ETML-ES-SLO/PRJ_2224_BuzzerWireGame/hard/A/2224_BuzzerWireGame/Project Outputs for 2224_BuzzerWireGame/EuroCircuits/2224_BuzzerWireGame-RectHoles.TXT

M48
;Layer_Color=9474304
;FILE_FORMAT=4:3
METRIC,LZ
;TYPE=PLATED
T10F00S00C2.200
;TYPE=NON_PLATED
%
G90
G05
T10
G00X005588Y0006941
M15
G01Y0007041
M16
G00X006898Y0006941
M15
G01Y0007041
M16
M30
