ETML-ES-SLO/PRJ_2224_BuzzerWireGame/doc/Design/Design.docx

Design

Ecole supérieure

Électronique

Laboratoire R110 PROJ

Buzzer Wire Game

Réalisé par :

Santiago Valiante

A l’attention de :

Mr. Bovey et Mr. Castoldi

Dates:

Début du laboratoire : 14 Décembre 2022

Fin du laboratoire : 26 Janvier 2023

# Table des matières

# Description du produit

WireGame est un jeu qui consiste à guider une boucle métallique le long d'une longueur de fil en serpentin, sans toucher. La boucle et le fil sont connectés à une source d'alimentation de telle manière que, s'ils se touchent, ils forment un circuit électrique fermé.

Le but de ce projet est de développer un WireGame dit « intelligent » et optimisé pour qu’une personne mal entendant puisse y jouer. Il sera possible de gérer le menu du système à travers une application C# depuis un PC connecter en USB ou manuellement avec un encodeur.

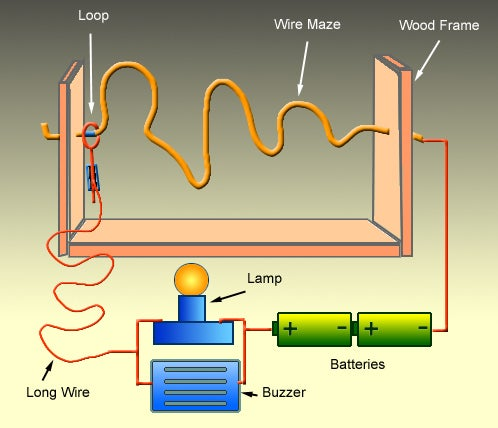
[picture p1: figure]
Buzz Wire Kit : 6 Steps (with Pictures) - Instructables

Figure 1

# Schéma bloc

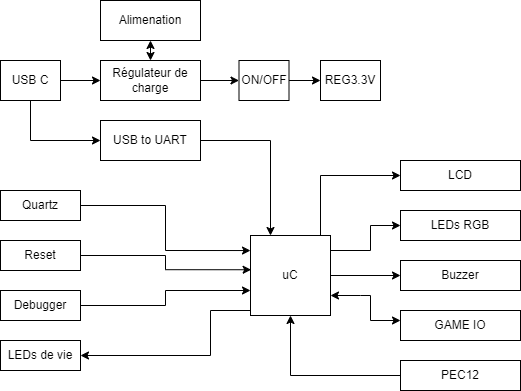
[picture p2: figure]

# Alimentation

## USB C

Afin de pouvoir communiquer avec un PC et recharger notre batterie Li-On. J’utilise un port USB C. Selon la note d’application (Figure 3), si nous sommes un device et que nous devons recharger notre système. Nous devons mettre deux résistances de 5k1 reliées à la masse aux sorties CC1 et CC2.

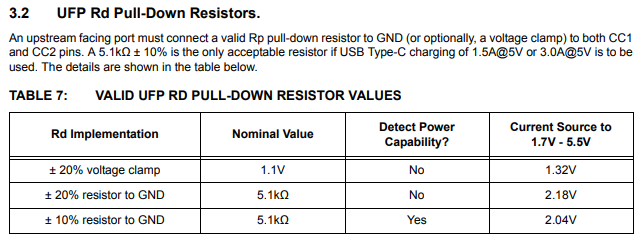
[picture p3: figure]
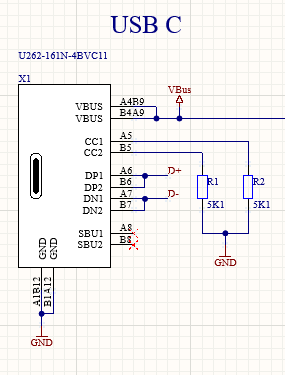
[picture p4: figure]

Figure 2 : Schéma USB C Figure 3 : Annotation note USB C

## Régulateur de charge et ON/OFF

Pour charger l’accumulateur, j’utilise un régulateur de charge MCP73871. Le modèle a été repris d’un design déjà utilisé à l’ETML-ES. J’utilise un switch afin de gérer l’alimentation de mon circuit.

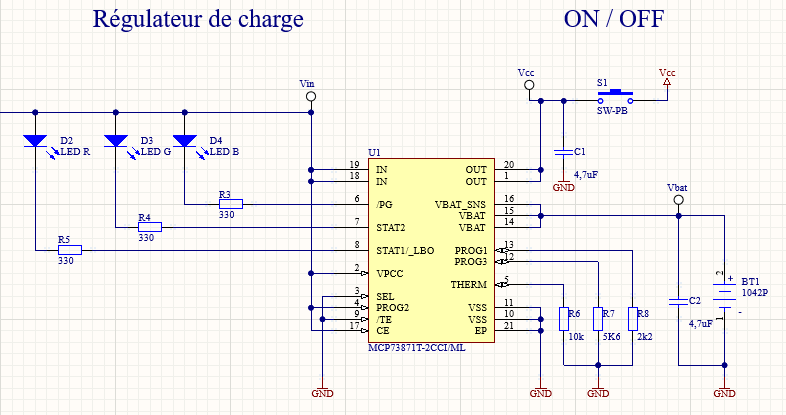
[picture p5: figure]

Figure 4 : Régulateur de charge et ON/OFF

Comme nous sommes en mode USB, la pin 3 (SEL) doit être mis à la masse.

Puis, la pin 9 (TE) sera mise à l’état bas pour activer la sécurité.

Pour finir, la pin 17 (CE) à l’état haut pour activer la charge.

Pour les états de sortie, nous avons 3 LED’s indicatives. Elles ne sont pas obligatoires, mais j’ai décidé de les mettre à titre d’indication pour connaître l’état de l’accu.

### Dimensionnement

Pour le dimensionnement des résistances et des condensateurs, il faut d’abord connaitre le courant maximum avec lequel on peut charger notre accumulateur (3400 mA). Les valeurs des condensateurs ont été prisent de l’exemple d’application (Figure 5). De même pour la résistance sur la sortie THERM.

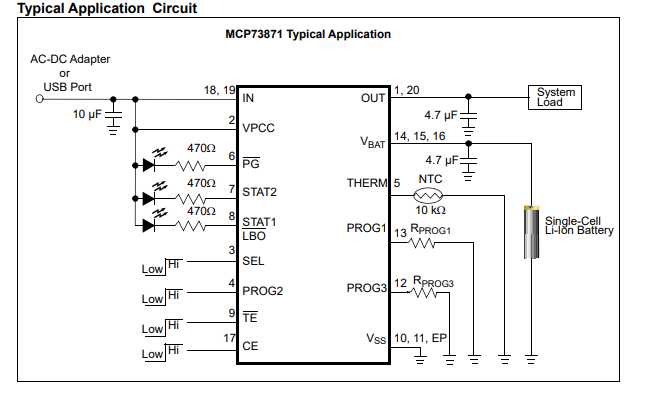
[picture p6: figure]

Figure 5 : Exemple MCP73871

#### Courant de régulation

Pour trouver la résistance Rprog1, il faut savoir le courant de régulation. Dans notre configuration, nous aurons un courant de 450 mA.

Figure 6: Configuration courant de charge

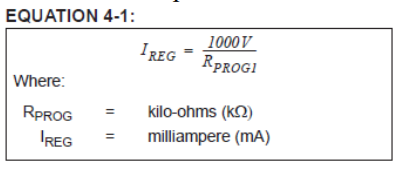
[picture p7: figure]

Figure 7 : Formule Rprog1

Rprog1=1000/(450m)=2k2

#### Courant de charge de terminaison

Pour trouver la résistance Rprog3, il faut savoir le courant de charge fixé depuis les informations de la batterie (3400 mA).

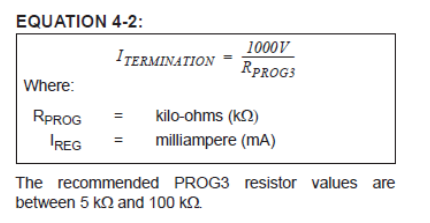
[picture p8: figure]

Figure 8 : Formule Rprog3

Iter=0,05C=0,05*3400m=170 mA

Rprog3=(1000V)/(170 mA)=5k8=>E24=5k6

## Accumulateur Liion

J’ai choisi de prendre un accumulateur à la place de piles, car cela est plus économique. Dans le cahier des charges une autonomie de 2h minimum a été demandé. Après une estimation du courant, dans le pire des cas (les leds RGB sont allumées pour une animation), nous avons donc une consommation d’environ 500 mA.

Capacité=Autonomie*Consomation=2*500m=1000 mAh

J’ai choisi de prendre le même accumulateur que mes camarades afin de faciliter la logistique. L’accumulateur a donc une capacité de 3400 mAh. J’aurais donc une autonomie de 6.8 h.

Autonomie=(Capacité)/(Consomation)=(3400m)/(500m)=6.8 h

## Régulateur 3,3V

Comme on est alimenté par un accumulateur la tension de sortie de celui-ci peut varier au fur et à mesure qu’il se décharge entre 2.5V et 5.5V. Un étage de remises à niveaux est nécessaire pour garantir une tension de 3,3V sur le micro et les divers modules qui fonctionnent à cette tension. J’ai repris un design de l’ETML-ES qui utilise le modèle MAX1793, il est notamment disponible dans les stocks de l’ES.

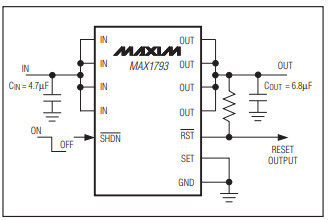
[picture p9: figure]
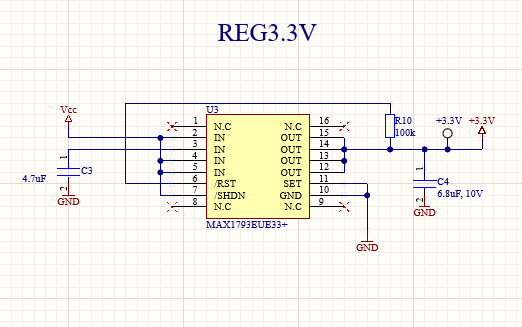
[picture p10: figure]

Figure 10: Régulateur 3.3V

Figure 9 : Circuit typique Régulateur 3.3V

## USB to UART

Afin de pouvoir se connecter au PC, on passera par un port USB C. Il faudra donc pouvoir lire les informations USB qui arriveront sur la carte. Pour cela un convertisseur USB vers UART sera utilisé.

Cela simplifie la prise en charge par le microcontrôleur de traiter une communication UART, plutôt qu’une communication USB lourde à traiter.

J’ai donc opté pour le composant « CY7C64225 » qui a déjà été utilisé lors d’un projet de l’ETML-ES. Pour le montage, un exemple du cas d’application alimenté en 3.3V a été suivi.

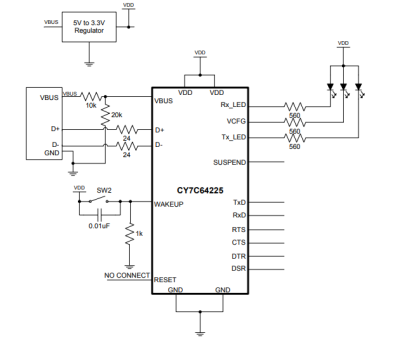
[picture p11: figure]
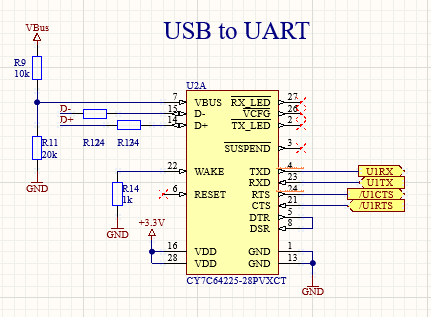
[picture p12: figure]

Figure 11: USB to UART Figure 12: Exemples USB to UART

# uC

Pour le choix du microcontrôleur, la famille PIC32 de Microchip a été conseillée dans le cahier des charges. Le 28 pin étant trop petit, j’ai donc choisi de prendre le PIC32MX250F128D à 44 pins, car j’ai besoin de seulement de la communication UART et de GPIO.

## Quartz

Le projet comprenant une communication UART. J’ai besoin d’un oscillateur pour avoir une vitesse en baud rate la plus précise possible.

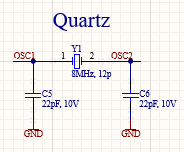
[picture p13: figure]

Figure 13: Quartz

Le calcul des condensateurs a été fait grâce au CL = 18pF et le C0 = 7pF du quartz utilisé.

C5=C6=2*(CL-C0)=2*(18-7)=22pF

## Reset

Afin de pouvoir reset le microcontrôleur lors de la phase de développement, un bouton poussoir a été placé. Le dimensionnement a été repris du kit micro utilisé au labo.

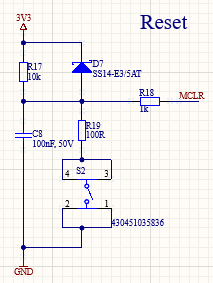
[picture p14: figure]

Figure 14: Reset

## Port de programmation

Le JTAG est là pour pouvoir programmer le microcontrôleur en chargeant le firmware à l’intérieur. Je pourrai également connecter le débuguer pour débugger en temps réel le firmware.

Le dimensionnement a été repris également du kit micro utilisé au labo. Il a été désigné pour accueillir un debuger « ICD3 ».

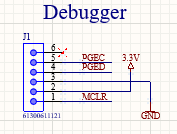
[picture p15: figure]

Figure 15 : Port de programmation

# Périphériques

## Game IO

Nous avons trois pull-up pour maintenir un état haut sur les entrées start, stop et wire. Lorsqu’on vient relier ces entrées avec la manette connectée au GND (pin 4 du header), nous aurons un état bas.

Il sera donc possible de détecter si nous avons touché le fil de cuivre ou si nous sommes au départ ou à l’arrivée du jeu.

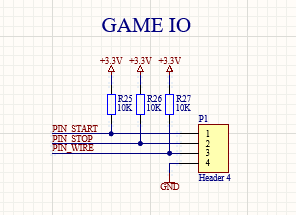
[picture p16: figure]

Figure 16: Game IO

## Encodeur Rotatif PEC12

Afin de pouvoir naviguer dans le menu et valider des actions, l’utilisation d’un encodeur a été demandé. Je me suis inspiré de celui du KIT microcontrôleur de l’ES.

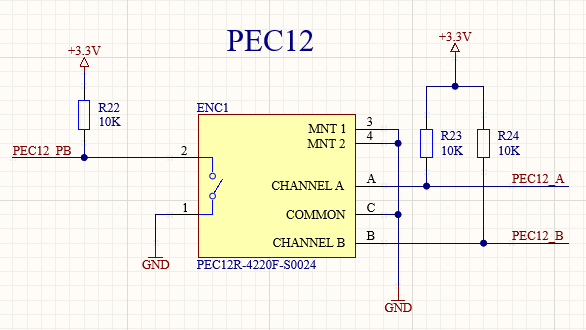
[picture p17: figure]

Figure 17 : PEC 12

## LCD

Afin d’afficher le menu, l’utilisation d’un LCD a été demandé. Je me suis inspiré de celui du KIT microcontrôleur de l’ES. Pour le back light du LCD, j’ai dû redimensionner les composants afin de fournir 20 mA.

Figure 18: Back light

R=(Uj)/I=(0,7)/(20m)=35=>33Ω

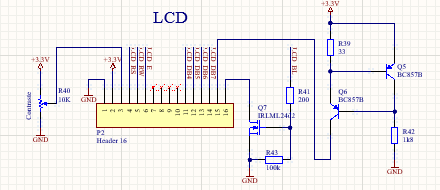
[picture p18: figure]

Figure 19: LCD

## Buzzer

Afin d’avoir une indication sonore, j’utilise un buzzer avec une tension de fonctionnement de 2.5V à 4.5V et d’une résistance de 16Ω. Le courant est limité à 20 mA.

I=U/R=(3,3)/(150+ 16)=19.8 mA

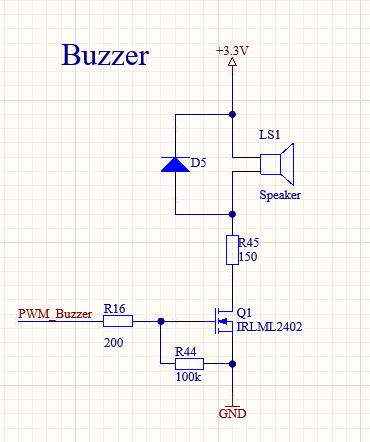
[picture p19: figure]

Figure 20:

## LED RGB

Afin d’avoir une animation visuelle, des leds RGB sont utilisées. Il me faut des leds assez puissantes pour pouvoir diffuser de la lumière dans un plexiglass opaque. Pour une question de logistique, je vais prendre les mêmes leds qu’un camarade.

Je ne vais pas utiliser le blanc, les couleurs me suffisent. Une led consomme 250 mA, pour une luminosité à 75%, il faudra donc une résistance de 22Ω.

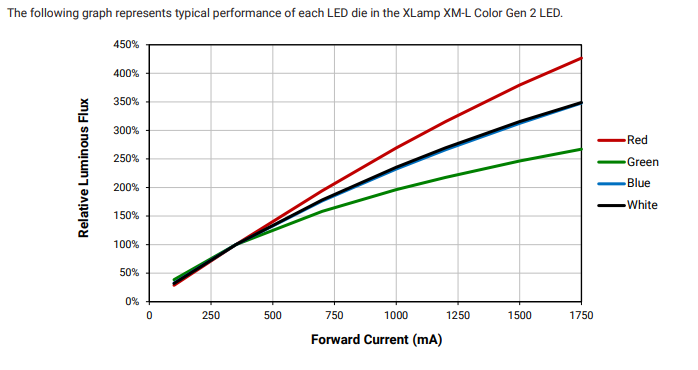
[picture p20: figure]

Figure 21: Courant - Luminosité

R=(3.3-UD)/I=(3.3-2.1)/(250m)=24=>22Ω

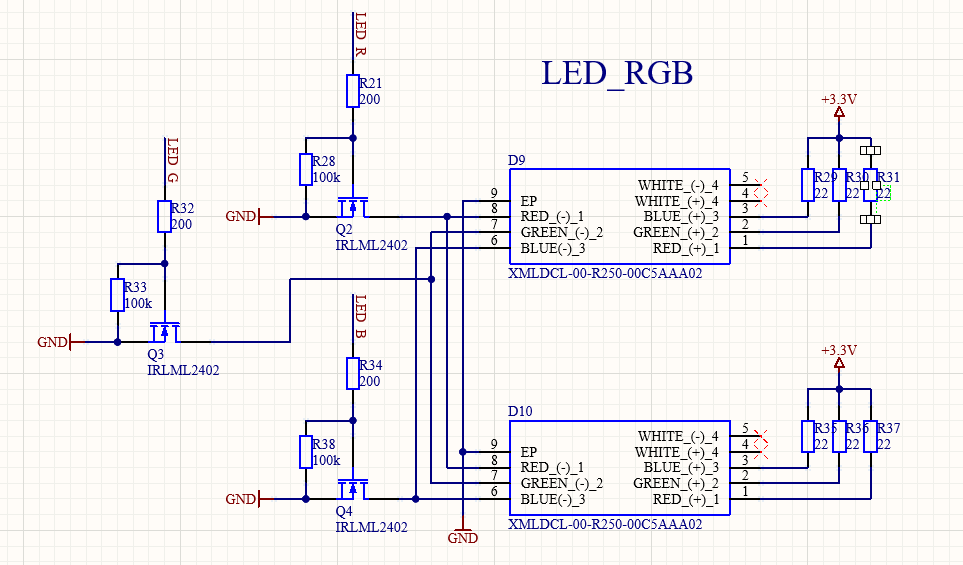
[picture p21: figure]

Figure 22: LED RGB

# Flowchart

### Firmware & Software

#### Application C#

Réaliser une interface de statistiques : meilleurs temps, nombre de fois toucher.

Réaliser différent mode de jeu : compte à rebours, nbr de touche max, ect.

##### Flowchart

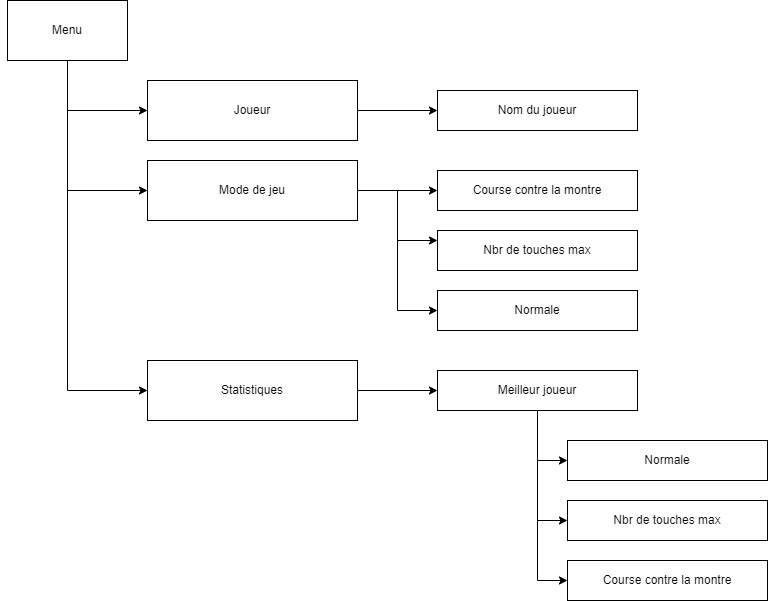
[picture p22: figure]

Figure 23

#### Firmware uC

Réaliser différent mode de jeu : compte à rebours, nbr de touche max, ect.

Gestion joueur.

##### Flowchart

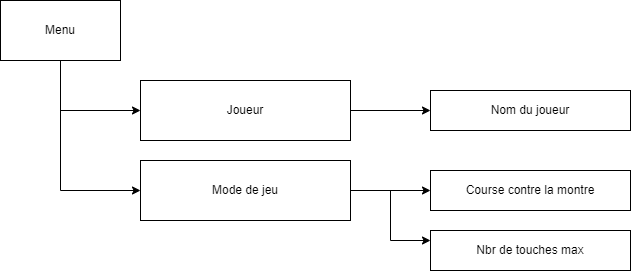
[picture p23: figure]

## Explications des interactions externes

Le joueur pourra interagir directement avec le système. Il y aura un bouton ON/OFF pour activer ou désactiver l’alimentation. A l’aide d’un affichage LCD et d’un encodeur, il pourra naviguer dans le menu. Mais, il pourra également interagir avec le système via un PC connecté via un port USB pour naviguer également dans le menu et en plus voir les statistiques des joueurs. Pour lancer le jeu, il suffira de décoller la boucle de la plaque de cuivre START et de même pour y mettre fin mais à l’arrivée (STOP).

Lausanne ETML-ES, 26.01.23. Santiago Valiante

Santiago Valiante Page 3

ETML Pré-étude PROJ
