ETML-ES-SLO/PRJ_2224_BuzzerWireGame/doc/Design/DESIGN.pptx

## Design 2224_BuzzerWireGame

Santiago Valiante

## Sommaire

- Schéma bloc
- Explication des différents blocs
- Flowchart
- Questions

## Schéma bloc

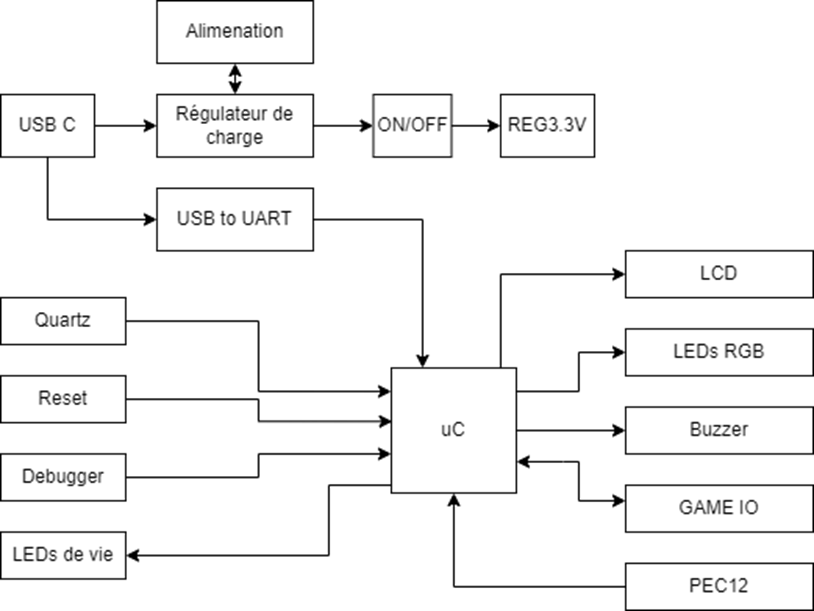
[picture p24: figure]

## Accumulateur Li-Ion

Capacité=Autonomie∗Consomation=2∗500m=1000 mAh

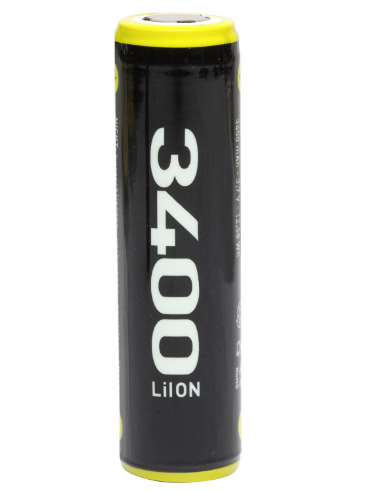
[picture p25: figure]

Autonomie=(Capacité)/(Consomation)=(3400m)/(500m)=6.8 h

Tension de 3,7 V (2,7V et 4,2V).

## USB-C


## Régulateur de charge


Rprog1=1000/(450m)=2k2

Rprog3=(1000V)/(170 mA)=5k8=>E24=5k6

## Régulateur 3.3V

Repris d’un projet de l’ETML-ES.


## USB to UART


Repris d’un projet de l’ETML-ES.


Notes: Cela simplifie la prise en charge par le microcontrôleur de traiter une communication UART, plutôt qu’une communication USB lourde à traiter.

## uC

PIC32MX250F128D à 44 pins

Repris d’un projet de l’ETML-ES.


## Périphériques


## Périphériques


R=(Uj)/I=(0,7)/(20m)=35=>33Ω

## Périphériques


I=U/R=(3,3)/(150+ 16)=19.8 mA

## Périphériques


R=(3.3−UD)/I=(3.3−2.1)/(250m)=24=>22Ω

## Flowchart Application C#


## Flowchart Firmware uC


## Questions ?

Notes: Faisabilité: possible dans les temps, tous les composants et compétences.
