ETML-ES-SLO/PRJ_2224_BuzzerWireGame/doc/Rapport Final/Mesures/InkedUART_TX.jpg

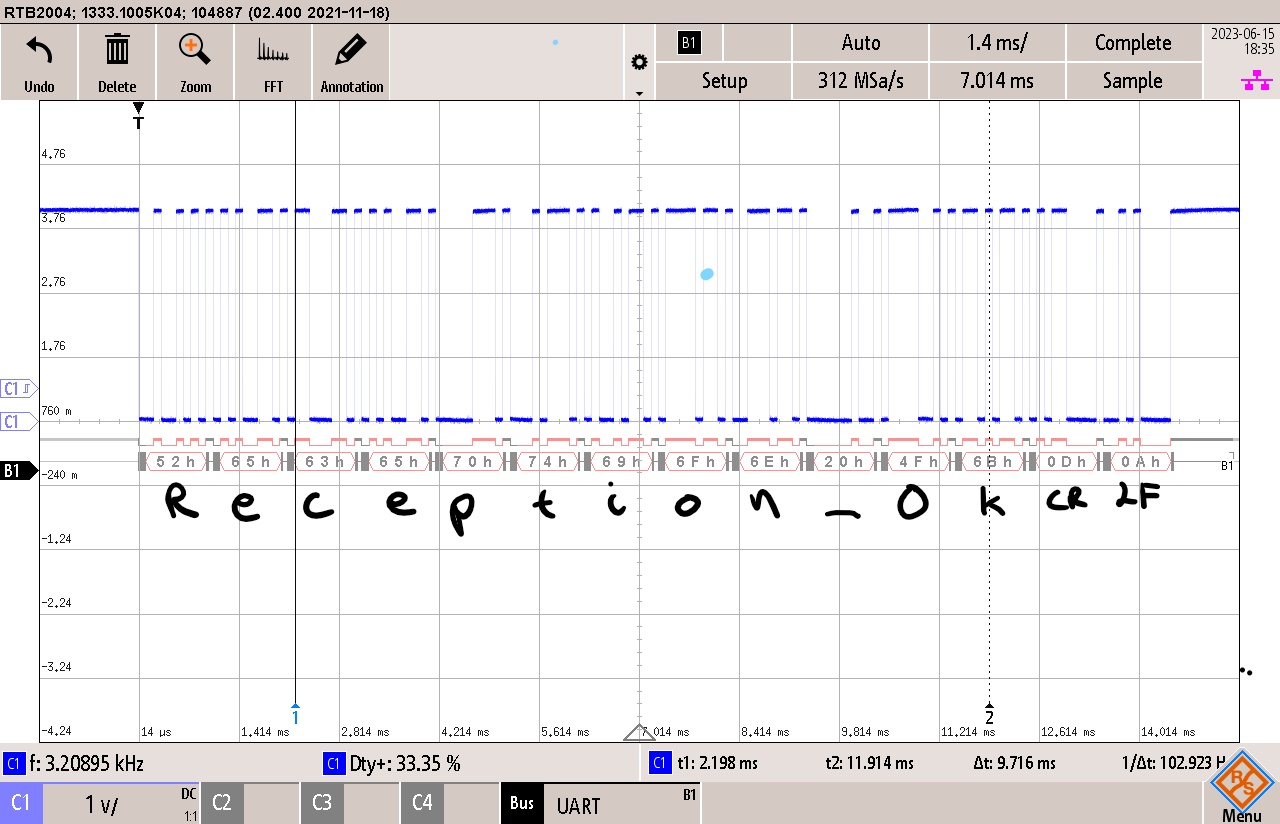
doc/Rapport Final/Mesures/InkedUART_TX.jpg
