ETML-ES-SLO/PRJ_2224_BuzzerWireGame/doc/Rapport Final/Mesures/UART_TX.png

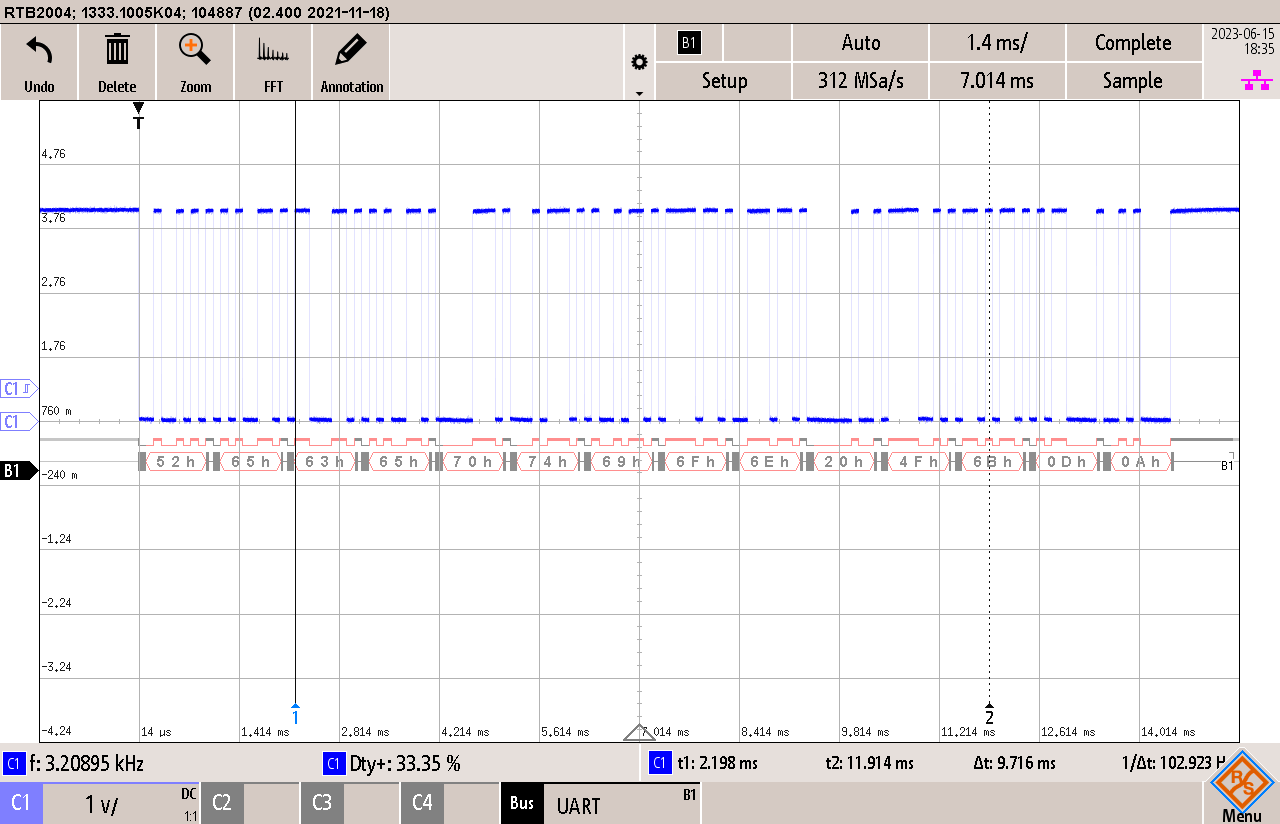
doc/Rapport Final/Mesures/UART_TX.png
