ETML-ES-SLO/PRJ_2224_BuzzerWireGame/doc/Rapport Final/JournalDeTravail_Valiante.xlsx

Journal de travail - PROJET
Date | Tâches | Problème rencontré
2022-11-16 | Choix du sujet
17.11.2022 + 1/2j 18.11.2022 | Rédiger cahier de charges
23.11.2022 + 1/2j 24.11.2022 | Rédiger cahier de charges, début pré-étude schéma bloc
2022-11-30 | Pré-étude : détaillé les blocs + Validation du CDC
2022-12-07 | Pré-étude : choix composants, estimation des prix, conclusion
2022-12-14 | Présentation pré-étude, début schématique | Déterminer l'accumulateur le plus vite possible
2022-12-21 | Corrections pré-étude + Schéma bloc précis des différents blocs
2023-01-11 | Déterminer l'accumulateur, choix des composants
2023-01-18 | Dimensionnement des fifférents blocs + schéma
2023-01-25 | Finalisation du schéma, rédaction du rapport
2023-02-01 | Finalisation du schéma + Revue schéma + Préparation présentation projet
2023-02-08 | Présentation schéma projet, modifications
2023-02-15 | RELACHES
2023-02-22 | Correction du schéma + Recherche des footprints aux composants
2023-03-01 | Recherche des footprints aux composants + placement composant
2023-03-08 | Mise à jour BOM - vérification footprints, composants en stock etc
2023-03-15 | Finir le rootage
2023-03-22 | Finalisation du design du PCB et contrôle avec EuroCircuits
2023-03-29 | Commande du PCB et commande des composants + Commencer la programmation
2023-04-05 | Montage du PCB
2023-04-12 | Vacances
2023-04-19 | Vacances
2023-04-26 | Finalisation du montage plus test de la carte
2023-05-03 | Validation régualteur 3v3, | Problème microcontrôleur
2023-05-10 | Checher problème + modification + validation microcontrôleur +Buzzer et Led RGB fonctionnells | problème venu de l'HW
2023-05-17 | LCD + Gestion du menu + Jeu | LED Rouge non fonctionnel
2023-05-24 | Gestion de menu + Jeu
2023-05-31 | Validation des périphériques + Gestion de menu + Jeu | Oubli de la communication UART
2023-06-07 | Résoudre problème du menu + Communication UART
2023-06-14 | Rapport + Communication UART + Tests
2023-06-20 | Présentation
2023-06-28
