ETML-ES-SLO/PRJ_2224_BuzzerWireGame/doc/Design/Alimentation.pdf

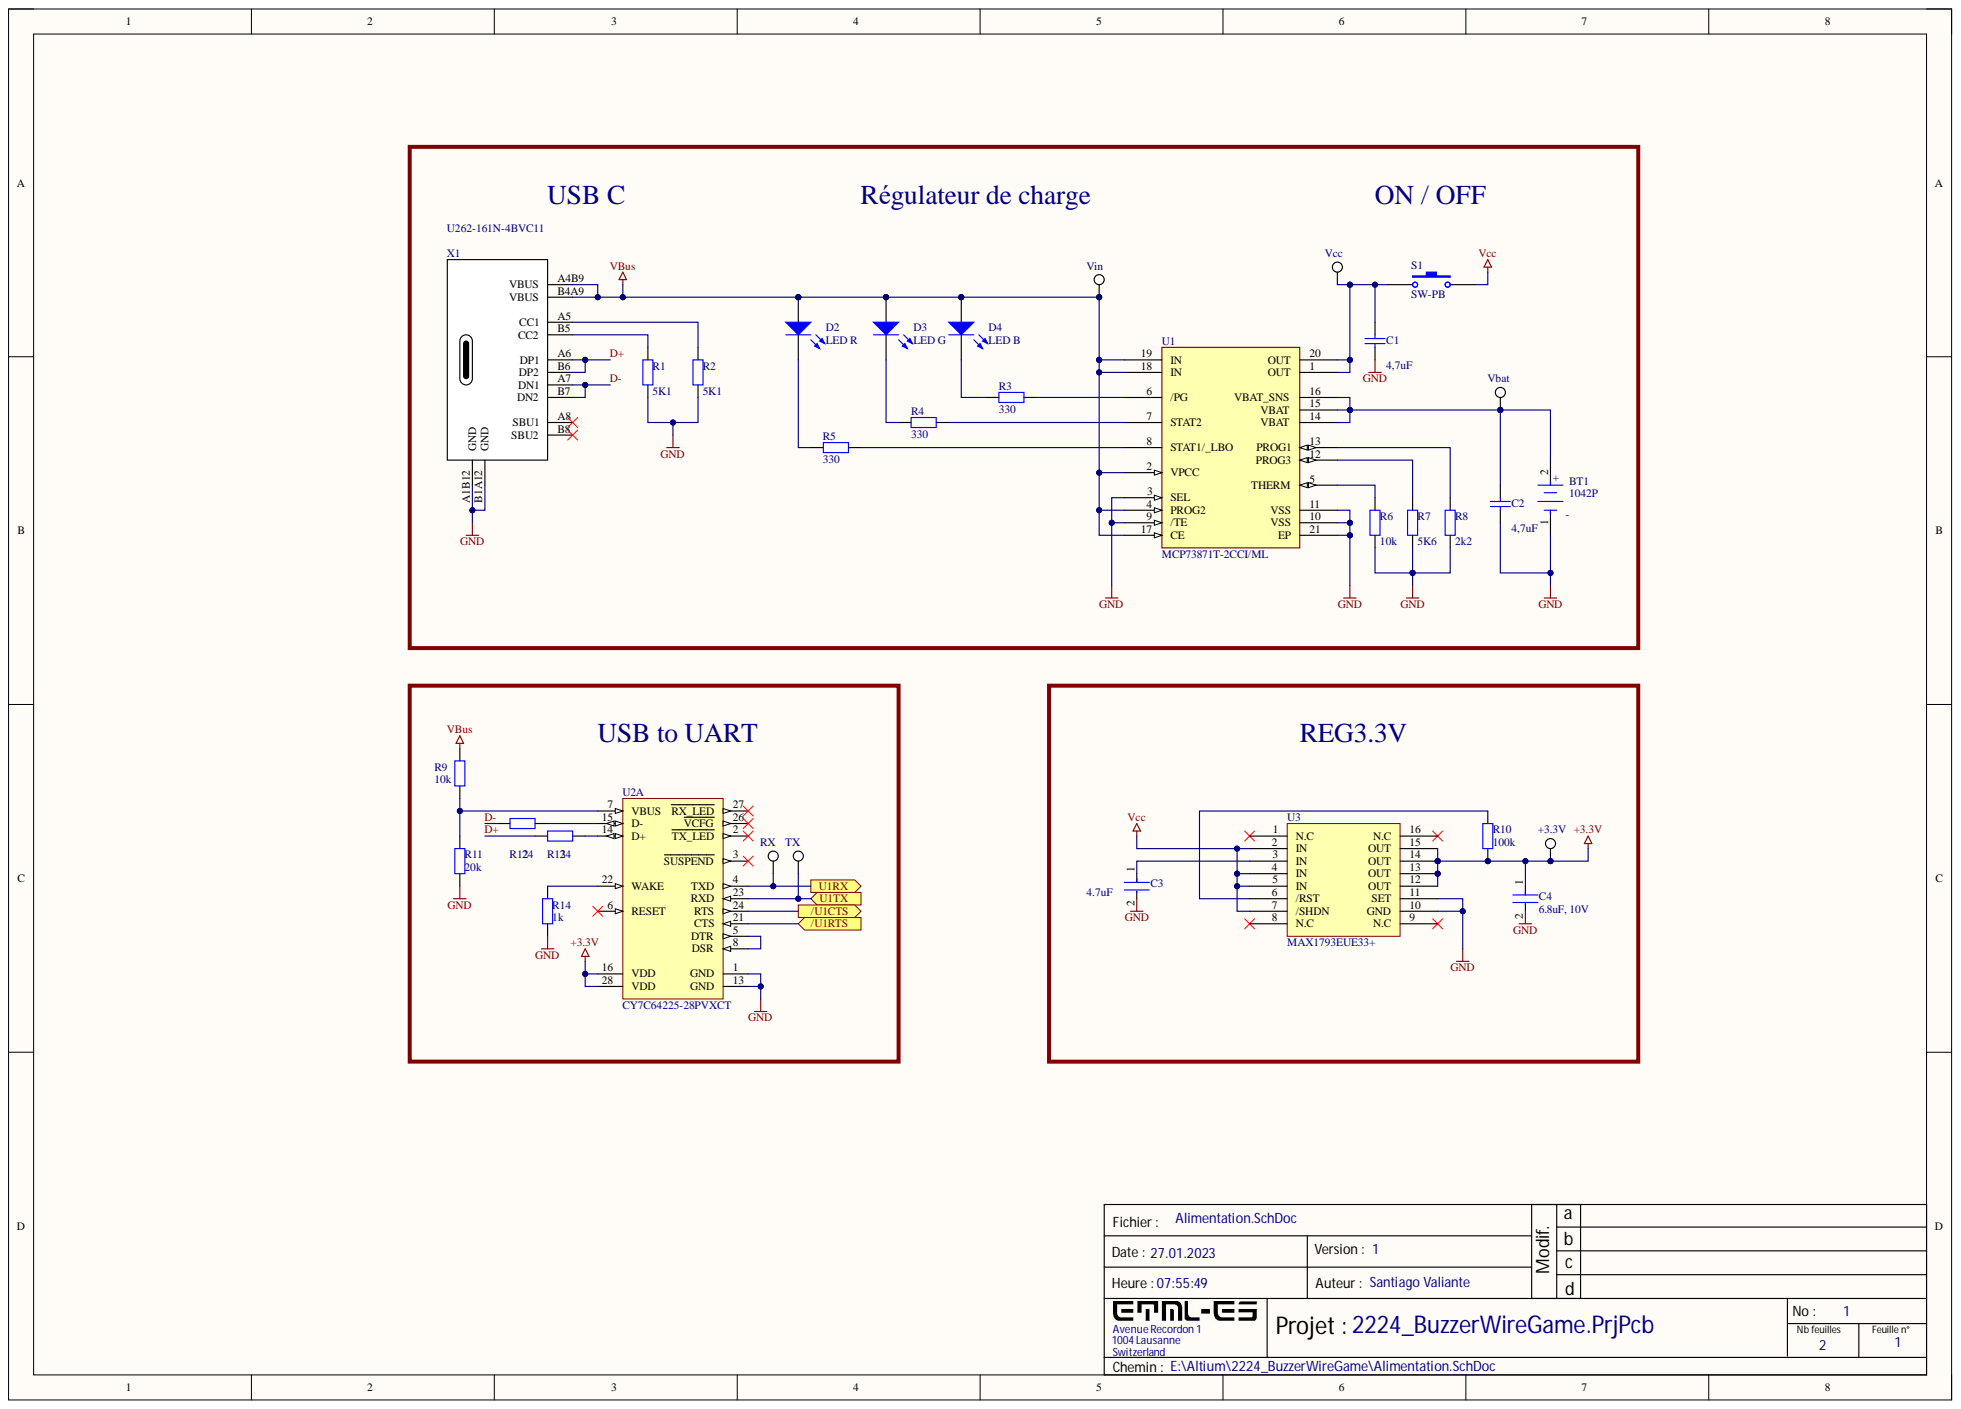
[picture p71: page 1]

D4 LED B

/PG 6 | GND

STAT1/_LBO 8

VPCC 2

SEL 3
PROG2 4

Alimentation.SchDoc Fichier : | | a

Date : 27.01.2023 | Version : 1

Heure : 07:55:49 | Auteur : Santiago Valiante
Avenue Recordon 1 1004 Lausanne Switzerland | Projet : 2224_BuzzerWireGame.PrjPcb | No : 1

Nb feuilles 2 | Feuille n° 1

Chemin : E:\Altium\2224_BuzzerWireGame\Alimentation.SchDoc
