ETML-ES-SLO/PRJ_2224_BuzzerWireGame/doc/Design/uC_IO.pdf

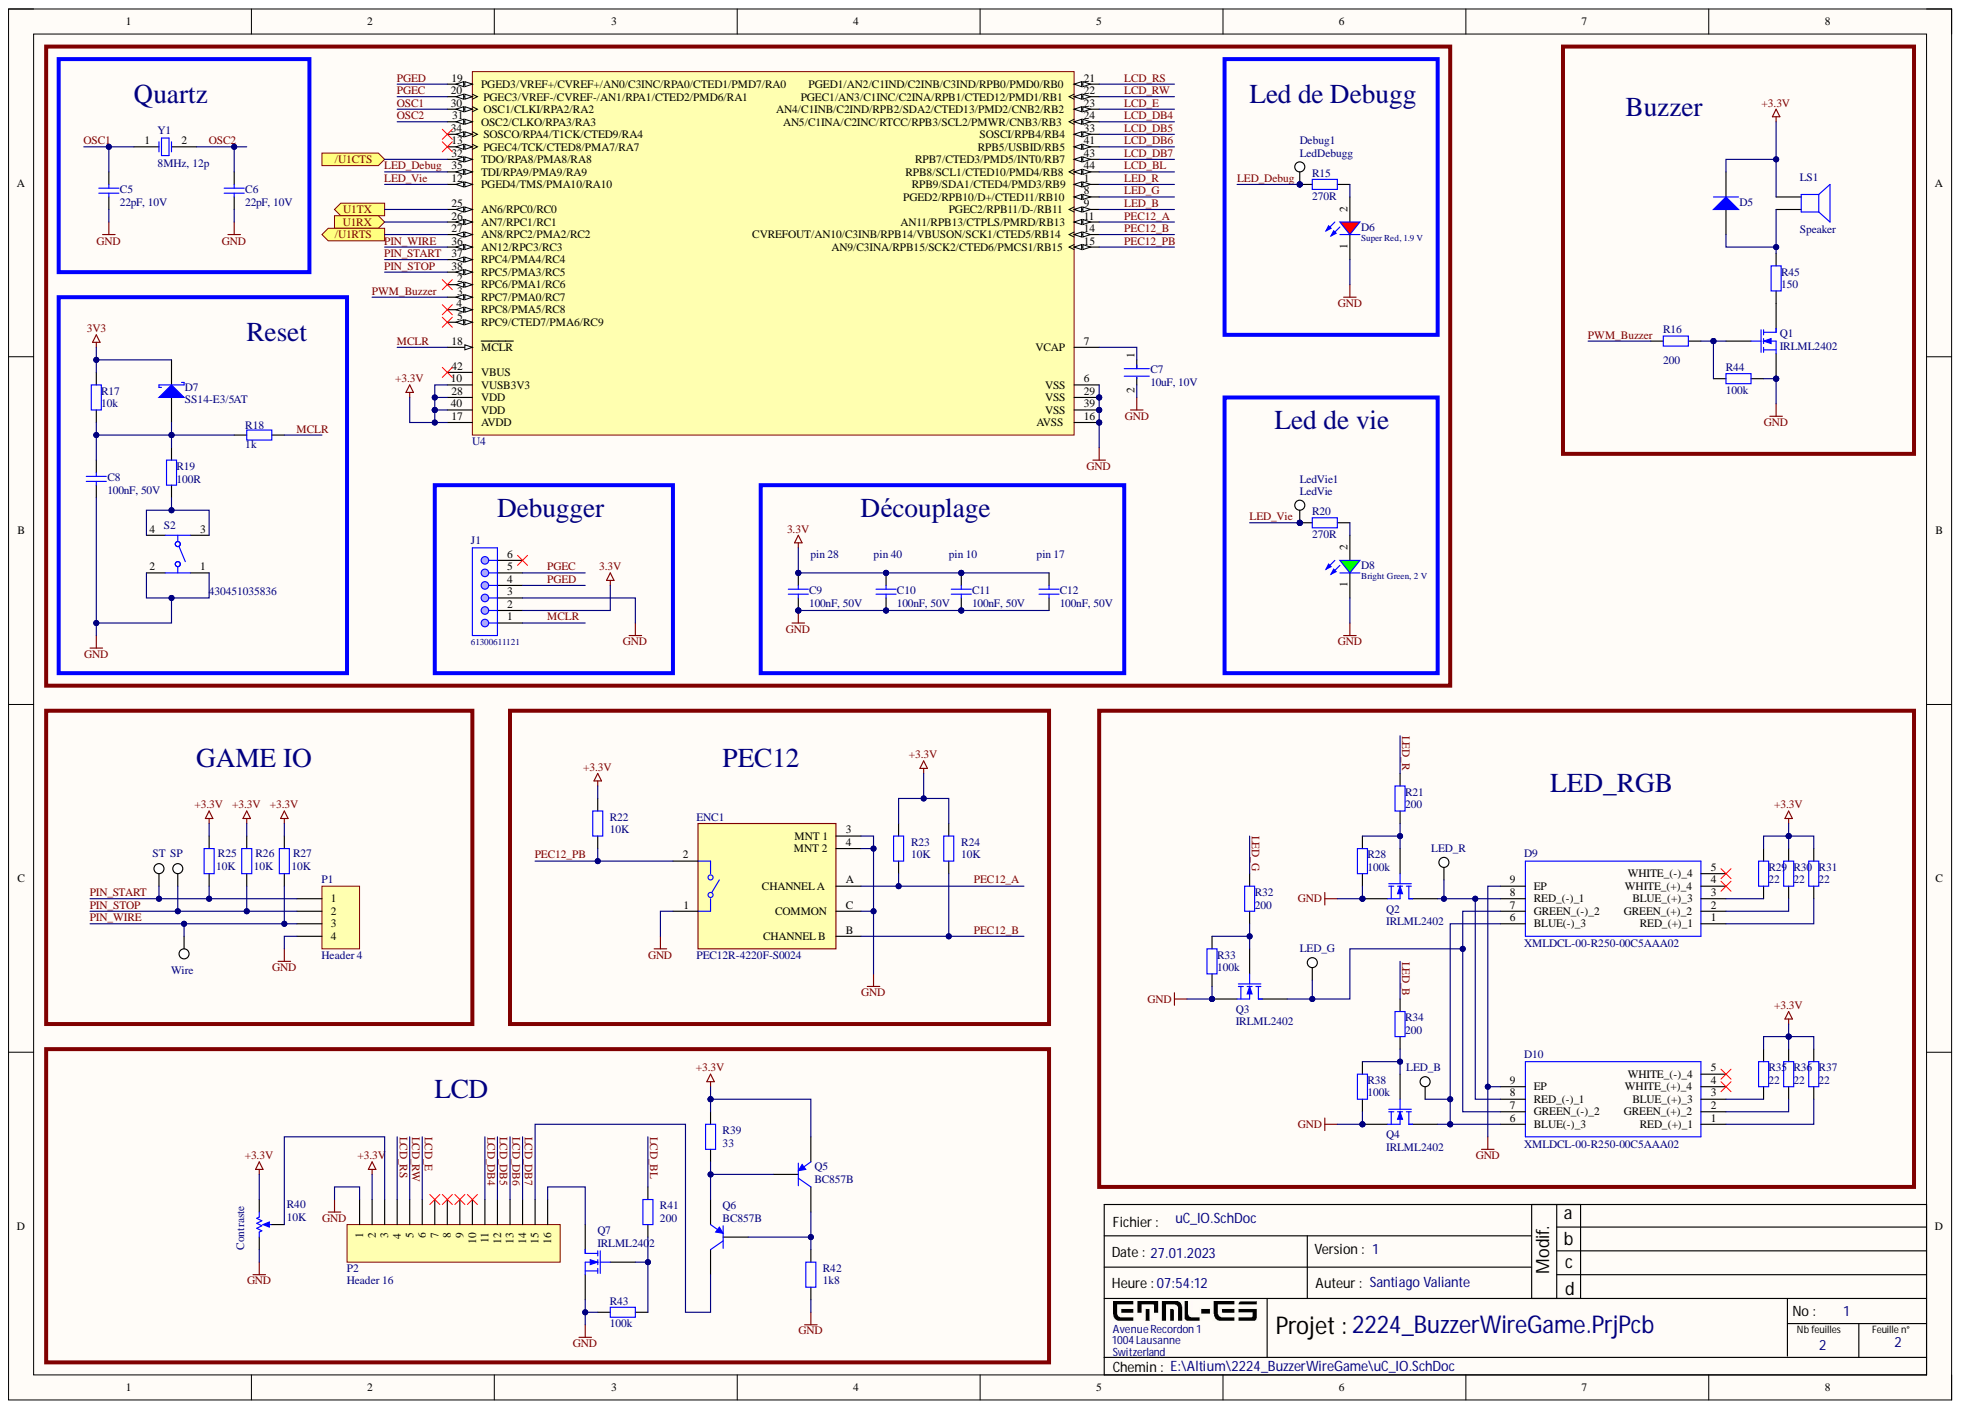
[picture p72: page 1]

uC_IO.SchDoc Fichier : | | a

Date : 27.01.2023 | Version : 1

Avenue Recordon 1 1004 Lausanne Switzerland | Projet : 2224_BuzzerWireGame.PrjPcb | No : 1

Nb feuilles 2 | Feuille n° 2
