ETML-ES-SLO/PRJ_2224_BuzzerWireGame/doc/Rapport Final/DesignDocs/Dimensional Drawings.PDF

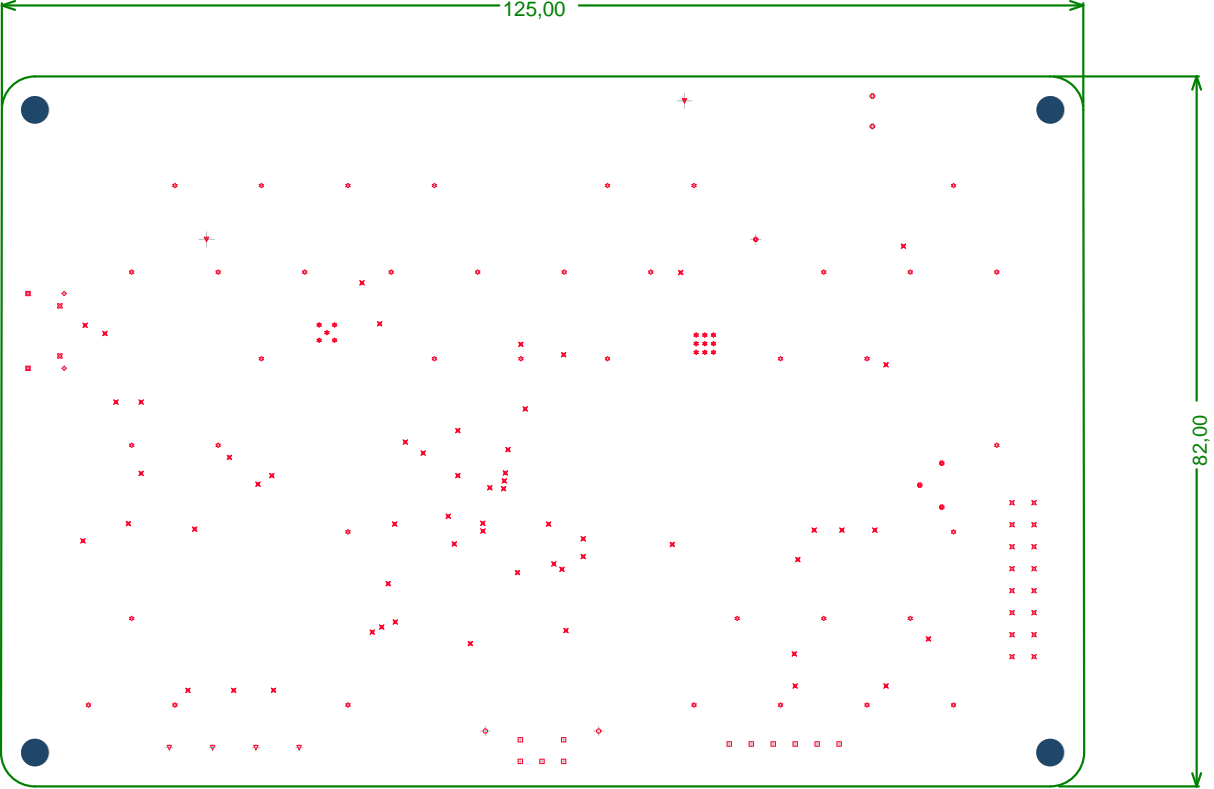
[picture p73: page 1]
