ETML-ES-SLO/PRJ_2224_BuzzerWireGame/doc/Rapport Final/DesignDocs/PCB Top-Bottom Assy Dwgs.PDF

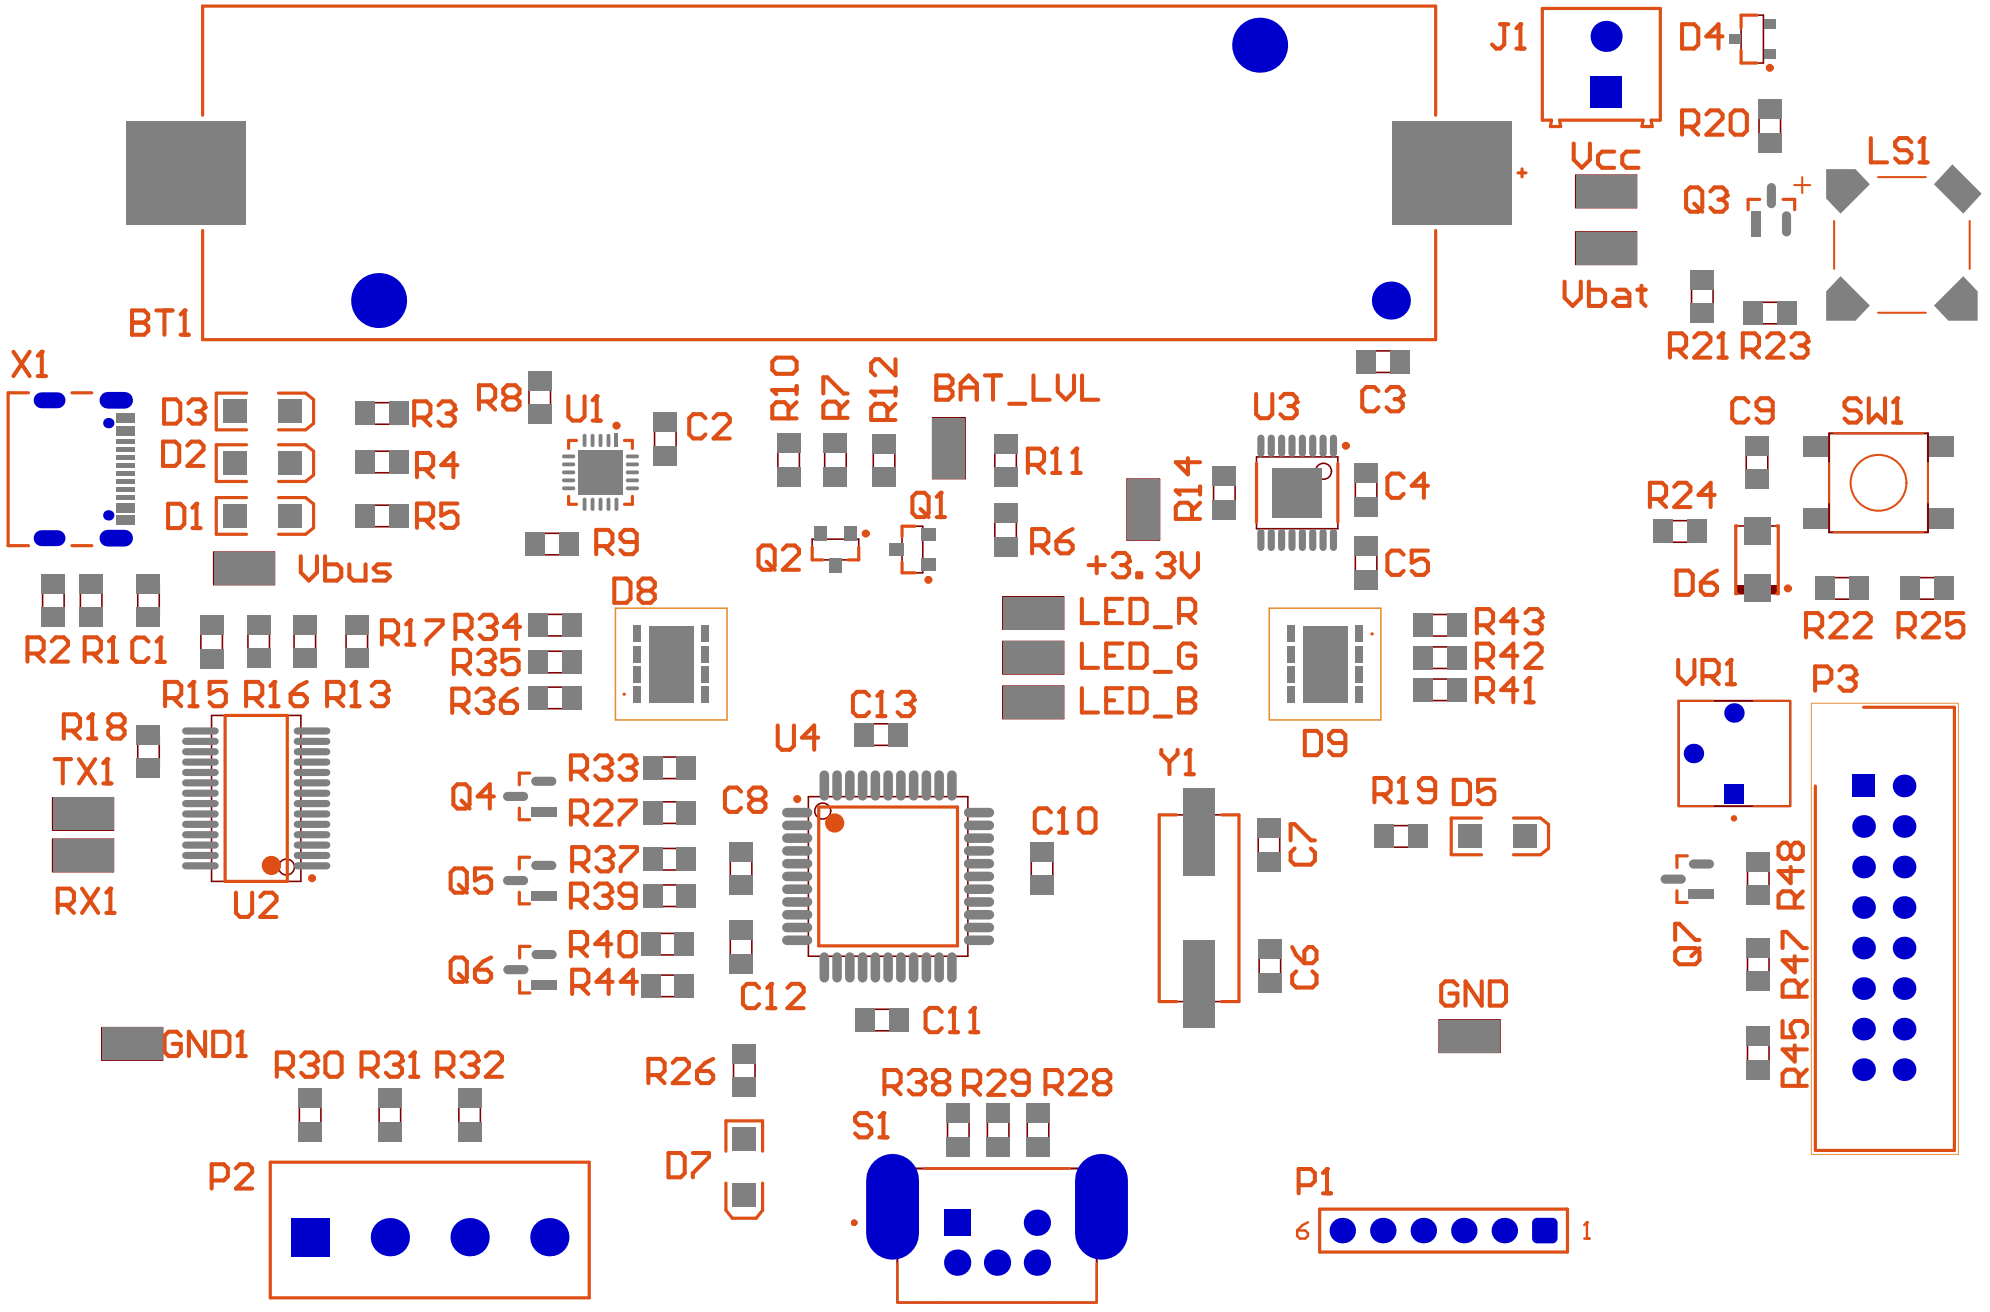
[picture p74: page 1]

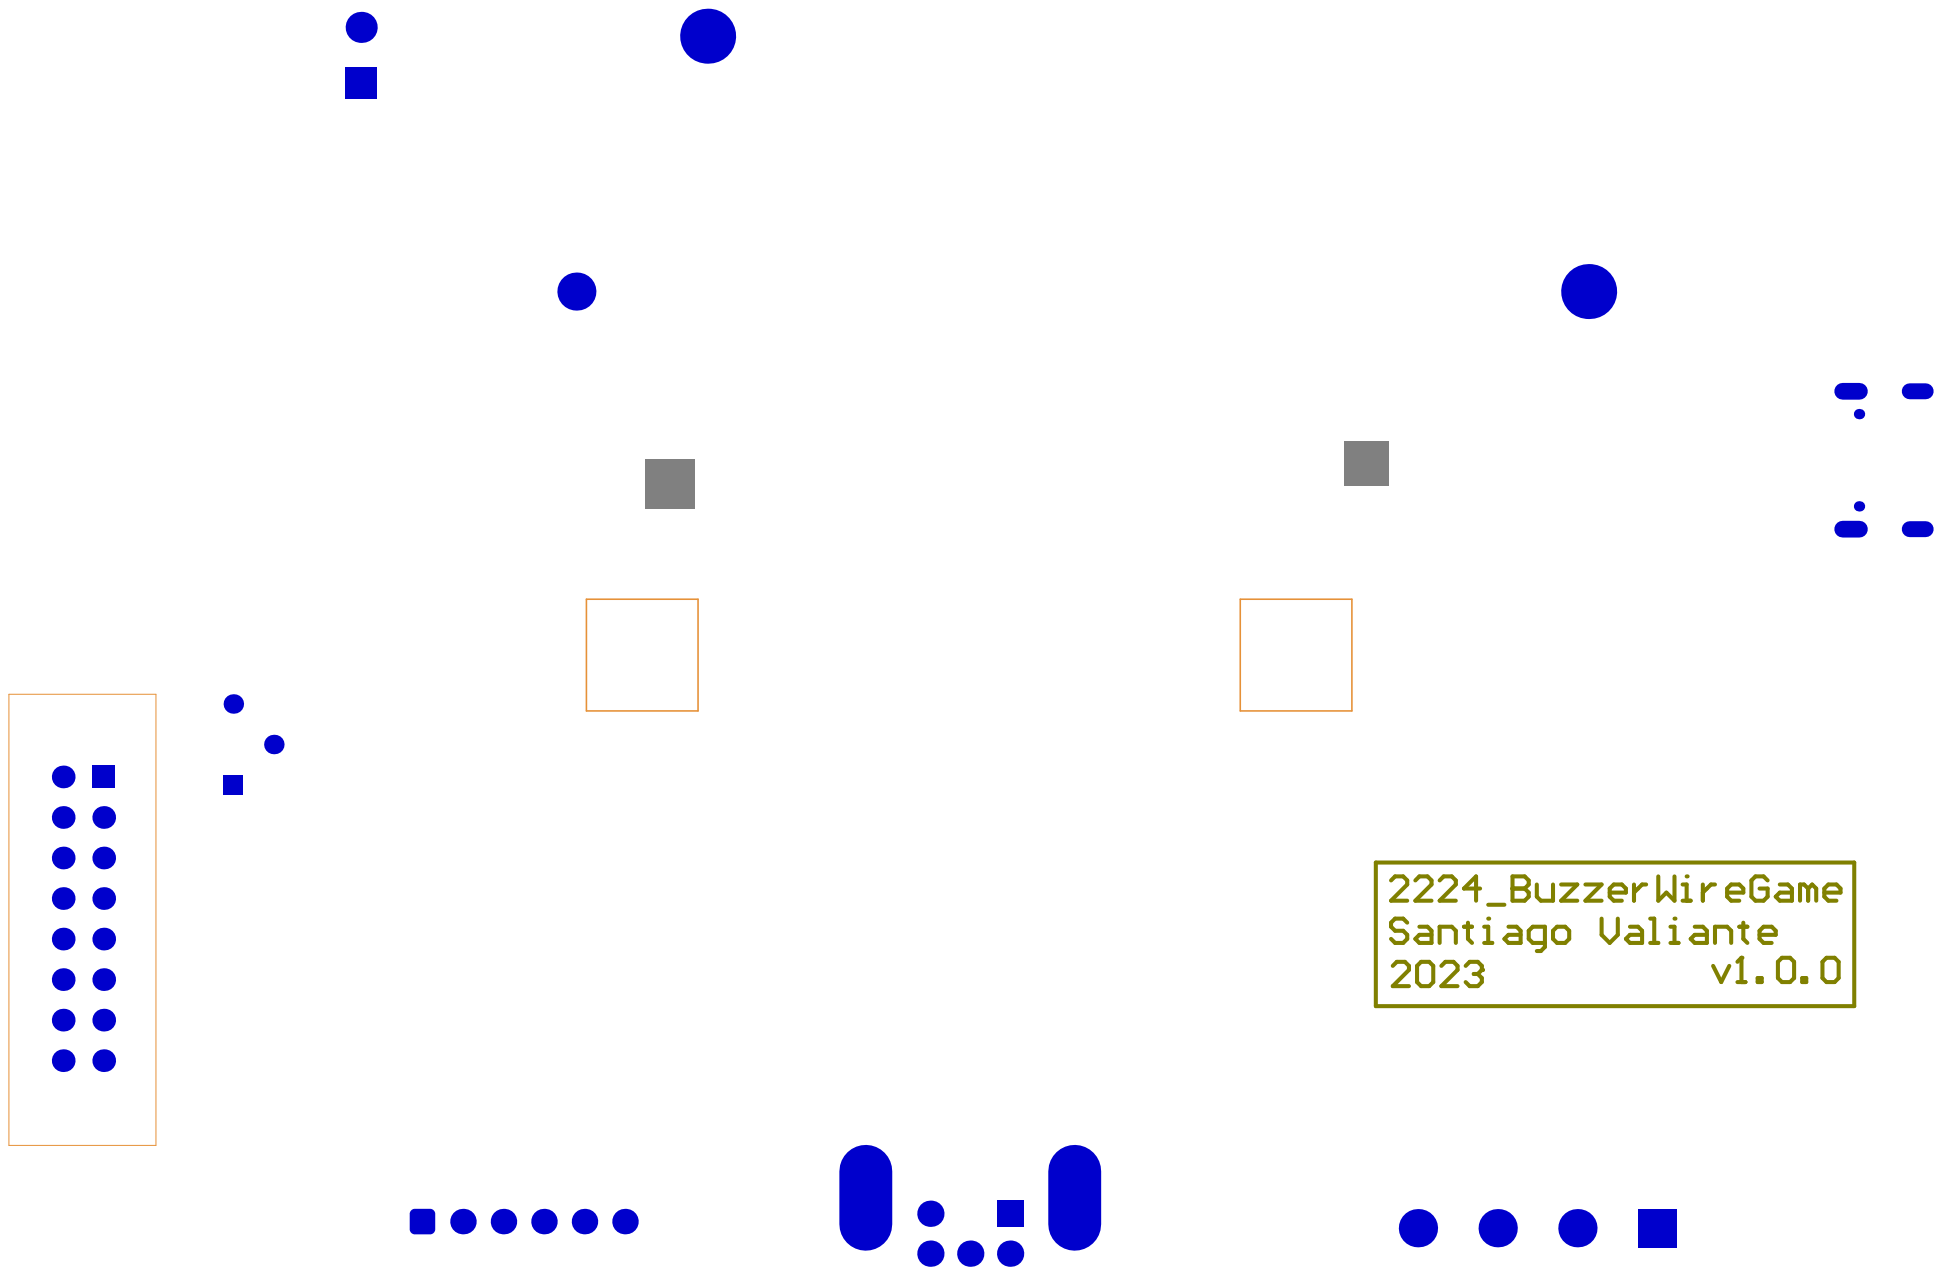
[picture p75: page 2]
