ETML-ES-SLO/PRJ_2224_BuzzerWireGame/hard/B/2224_BuzzerWireGame/Project Outputs for 2224_BuzzerWireGame/DesignDocs/Schematic Prints.PDF

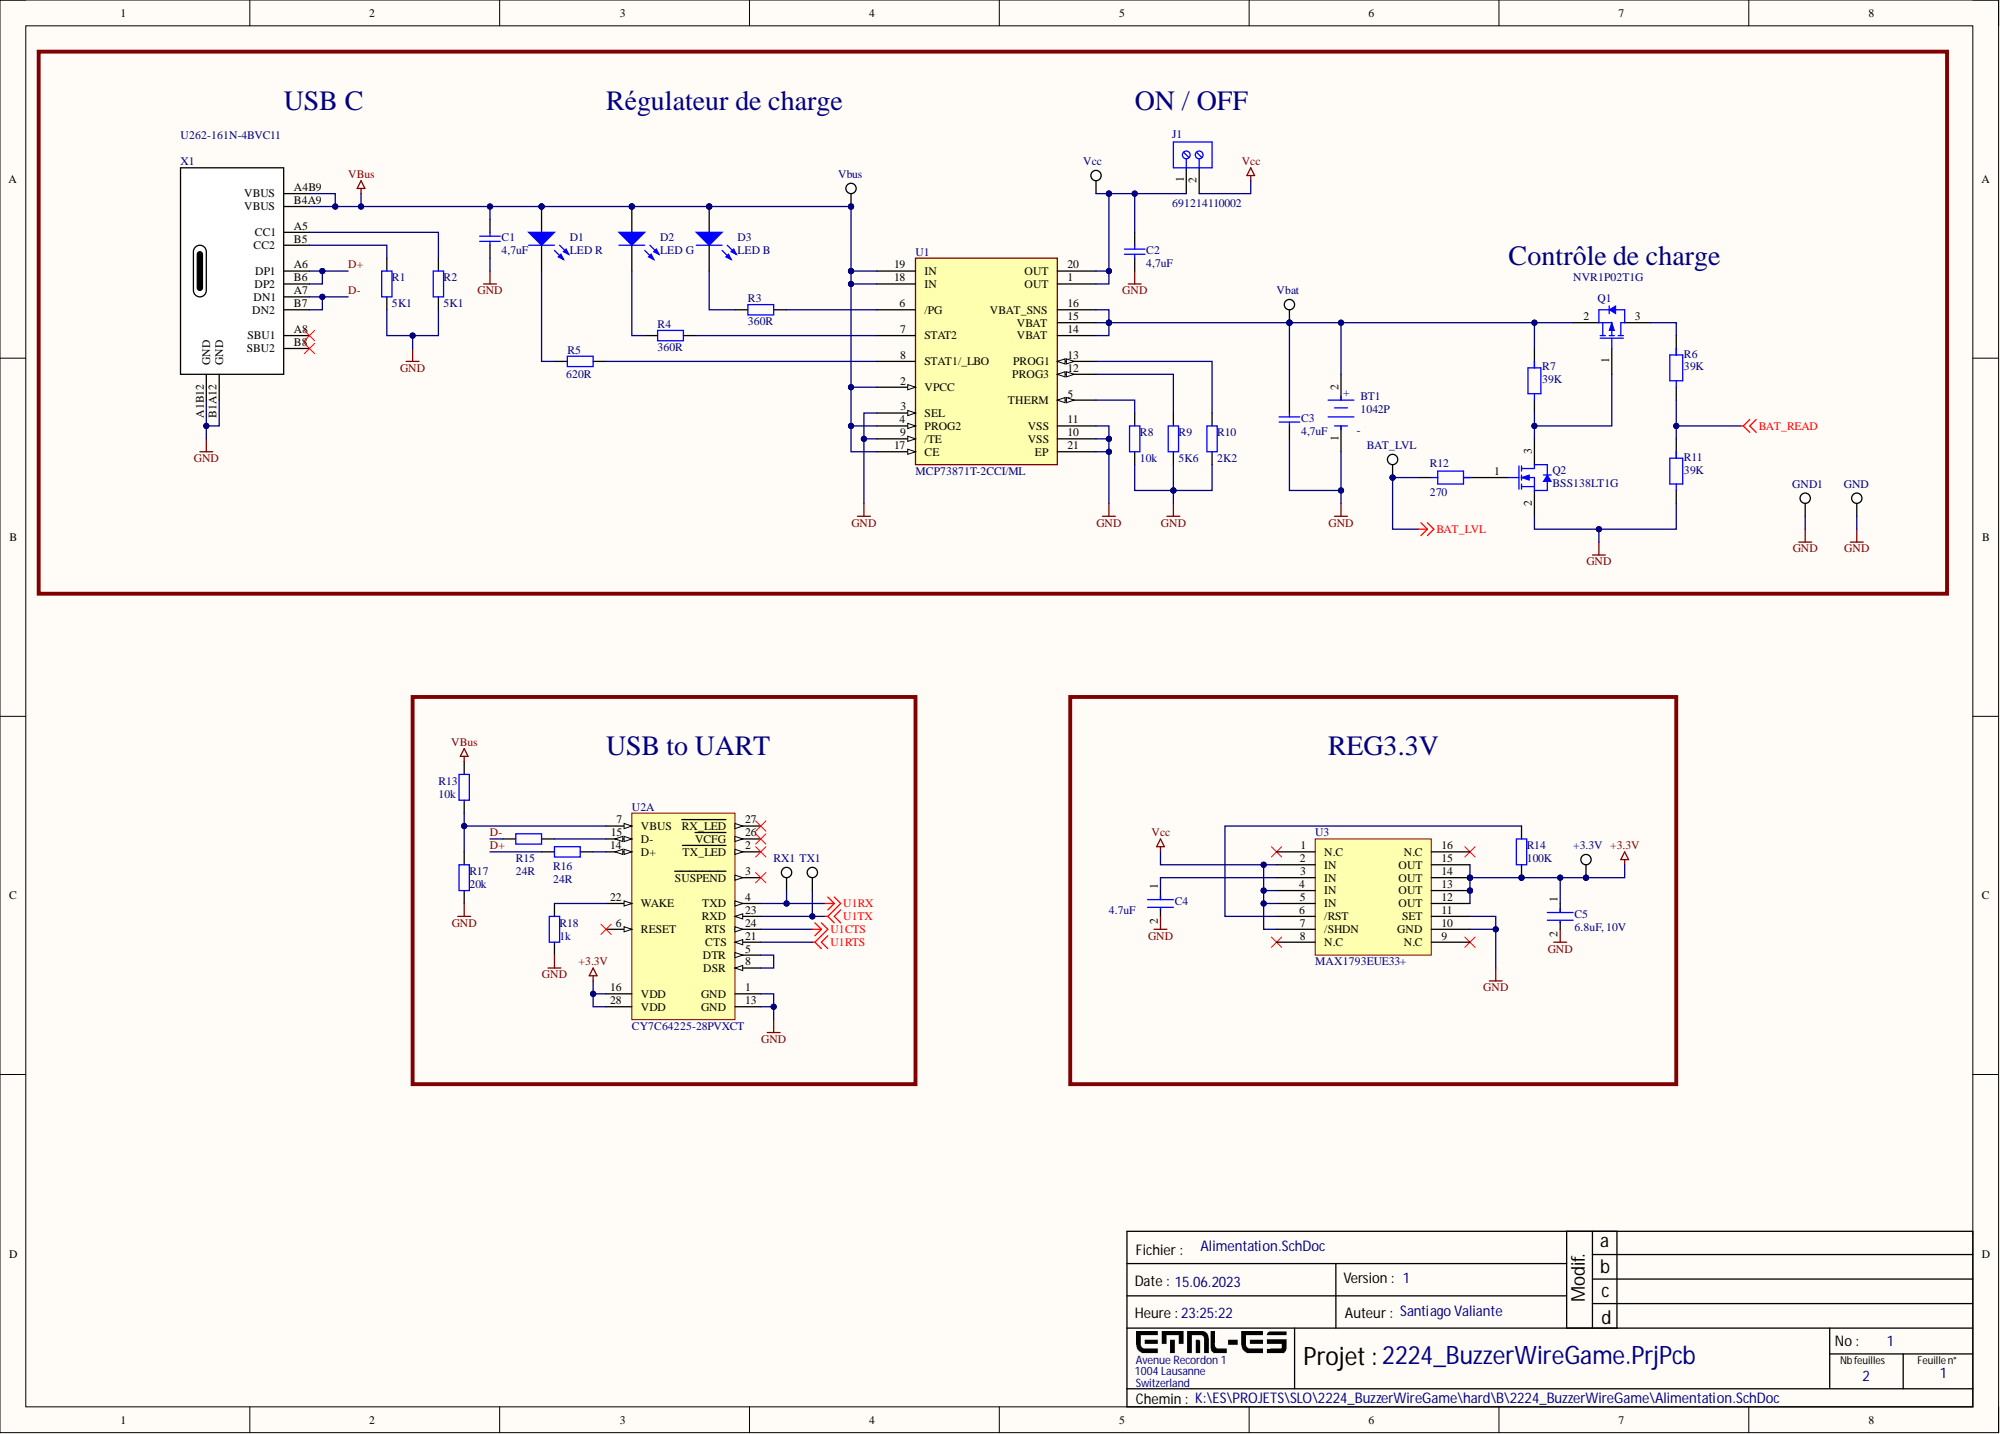
[picture p78: page 1]

13 VBAT 14 VBAT 15 2 PROG1

9 | 1 0
1 7 | 2 1

Alimentation. SchDoc Fichier :

Date : 15.06.2023 | Version : 1

Heure : 23:25:22 | Auteur :
Avenue Re cordon 1 1 004 Lausanne Switzerland | Projet | No : 1

Nb feuille s 2 | F euille n° 1

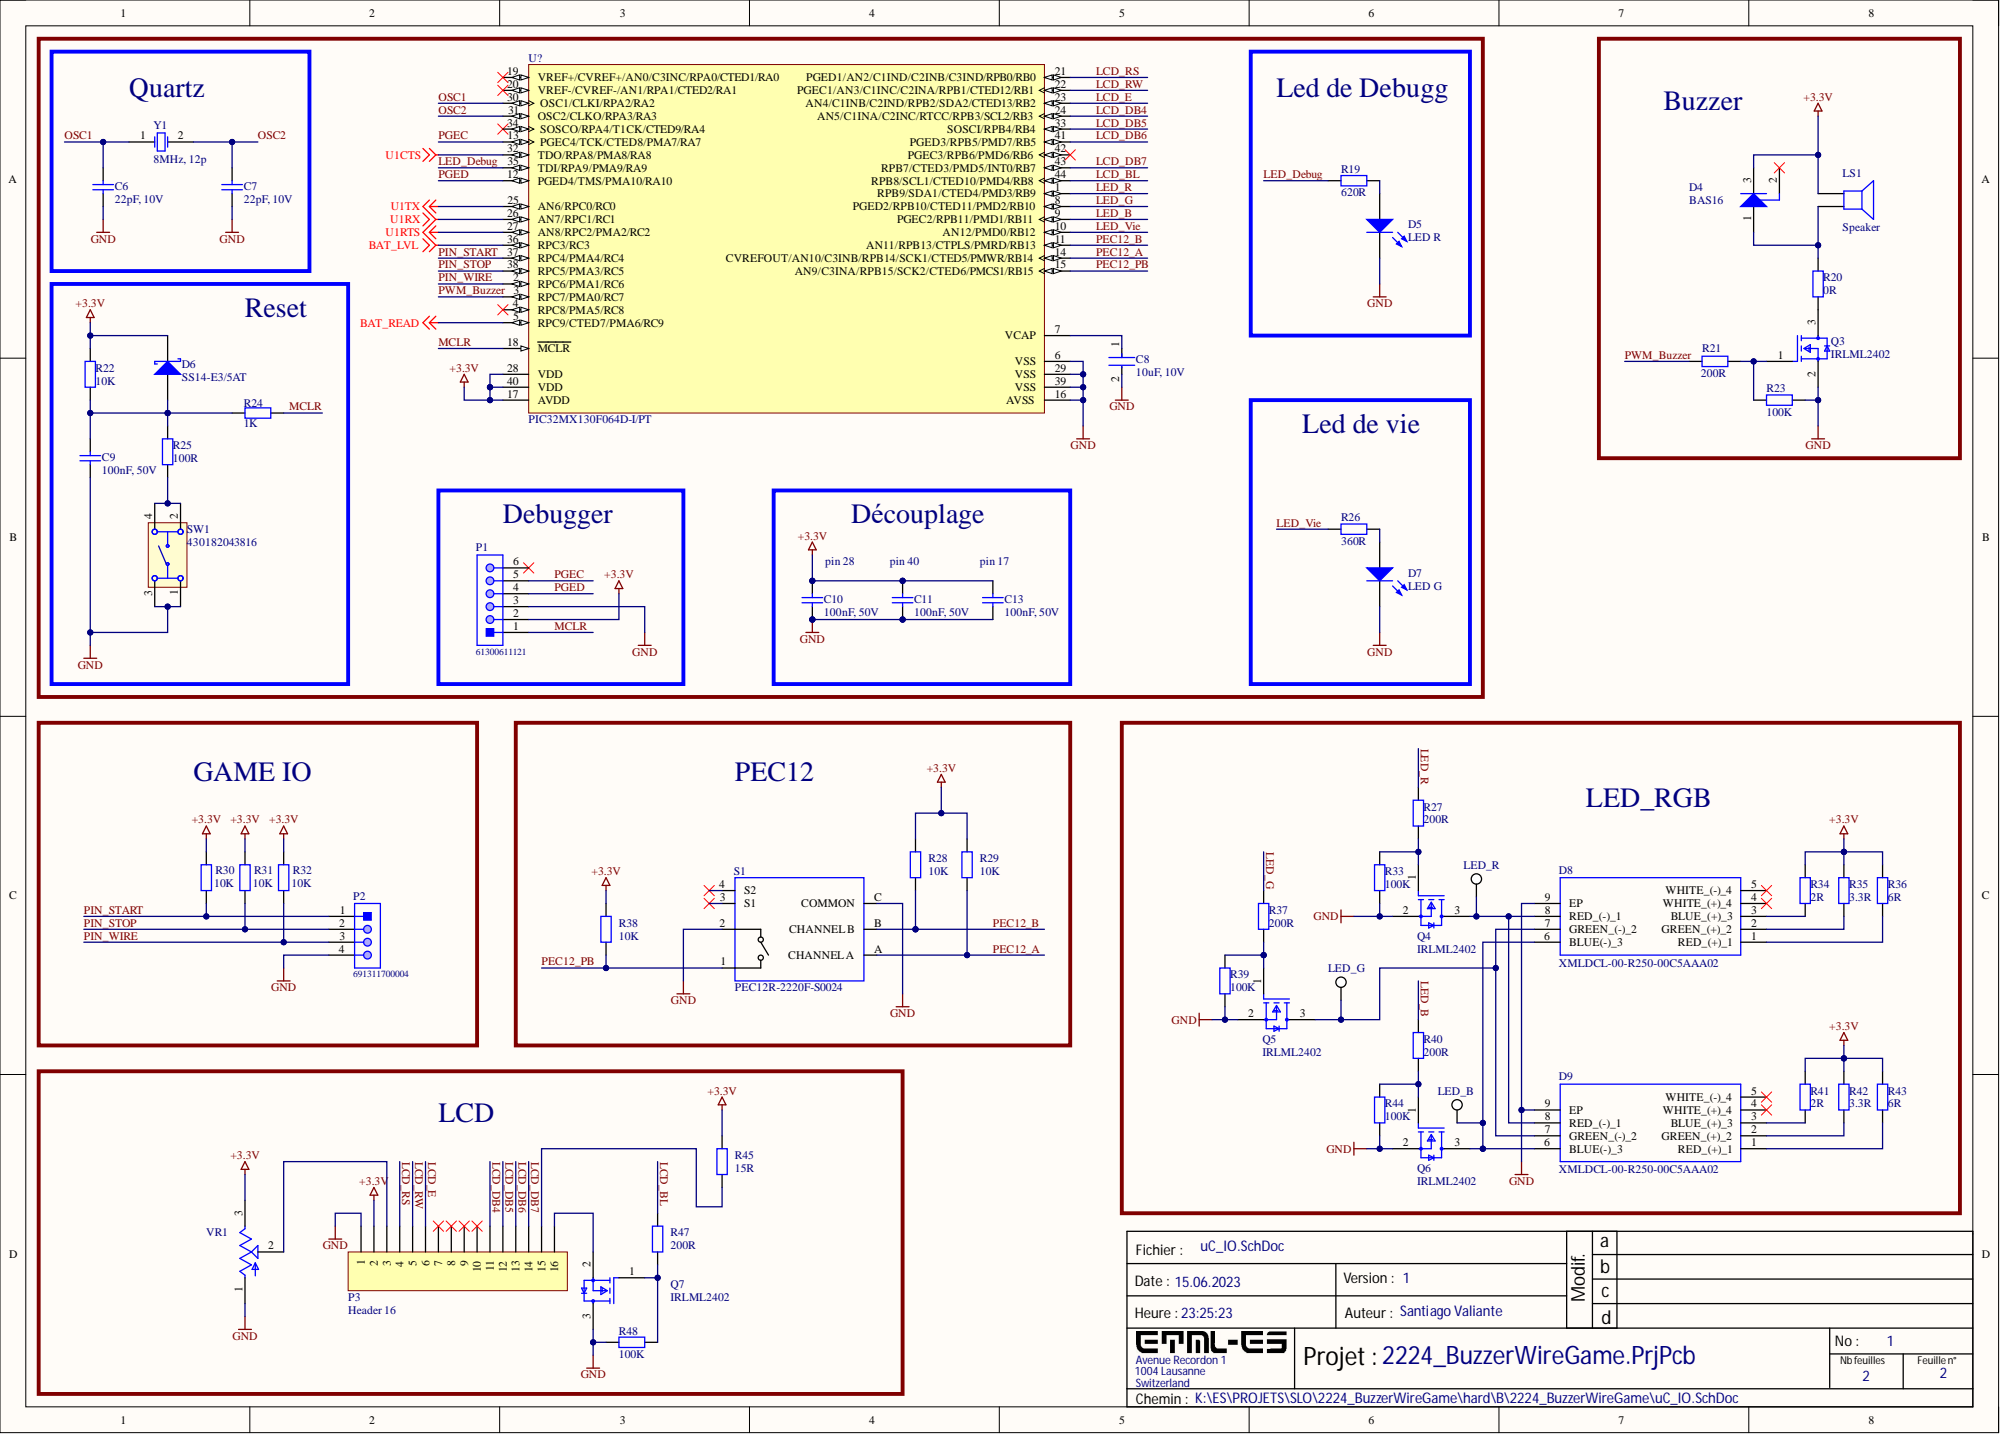
[picture p79: page 2]

uC_IO.SchDoc Fichier : | | a

Date : 15.06.2023 | Version : 1

Heure : 23:25:23 | Santiago Valiante Auteur :
Avenue Recordon 1 1004 Lausanne Switzerland | Projet : 2224_BuzzerWireGame.PrjPcb | No : 1

Nb feuilles 2 | Feuille n° 2

Chemin : K:\ES\PROJETS\SLO\2224_BuzzerWireGame\hard\B\2224_BuzzerWireGame\uC_IO.SchDoc
