ETML-ES-SLO/PRJ_2224_BuzzerWireGame/(list of files, drawings)

Other design files:
hard/A/2224_BuzzerWireGame/2224_BuzzerWireGame.PrjPcb
hard/A/2224_BuzzerWireGame/Alimentation.SchDoc
hard/A/2224_BuzzerWireGame/History/Alimentation.~(39).SchDoc/Alimentation.~(39).SchDoc
hard/A/2224_BuzzerWireGame/uC_IO.SchDoc
hard/B/2224_BuzzerWireGame/2224_BuzzerWireGame.PcbDoc
hard/B/2224_BuzzerWireGame/2224_BuzzerWireGame.PrjPcb
hard/B/2224_BuzzerWireGame/Alimentation.SchDoc
hard/B/2224_BuzzerWireGame/History/Alimentation.~(39).SchDoc/Alimentation.~(39).SchDoc
hard/B/2224_BuzzerWireGame/uC_IO.SchDoc
