ETML-ES-SLO/PRJ_2224_BuzzerWireGame/soft/2224_BuzzerWireGame_Demo/firmware/src/system_config/default/system_config.h

/*******************************************************************************
  MPLAB Harmony System Configuration Header

  File Name:
    system_config.h

  Summary:
    Build-time configuration header for the system defined by this MPLAB Harmony
    project.

  Description:
    An MPLAB Project may have multiple configurations.  This file defines the
    build-time options for a single configuration.

  Remarks:
    This configuration header must not define any prototypes or data
    definitions (or include any files that do).  It only provides macro
    definitions for build-time configuration options that are not instantiated
    until used by another MPLAB Harmony module or application.

    Created with MPLAB Harmony Version 2.06
*******************************************************************************/

// DOM-IGNORE-BEGIN
/*******************************************************************************
Copyright (c) 2013-2015 released Microchip Technology Inc.  All rights reserved.

Microchip licenses to you the right to use, modify, copy and distribute
Software only when embedded on a Microchip microcontroller or digital signal
controller that is integrated into your product or third party product
(pursuant to the sublicense terms in the accompanying license agreement).

You should refer to the license agreement accompanying this Software for
additional information regarding your rights and obligations.

SOFTWARE AND DOCUMENTATION ARE PROVIDED AS IS WITHOUT WARRANTY OF ANY KIND,
EITHER EXPRESS OR IMPLIED, INCLUDING WITHOUT LIMITATION, ANY WARRANTY OF
MERCHANTABILITY, TITLE, NON-INFRINGEMENT AND FITNESS FOR A PARTICULAR PURPOSE.
IN NO EVENT SHALL MICROCHIP OR ITS LICENSORS BE LIABLE OR OBLIGATED UNDER
CONTRACT, NEGLIGENCE, STRICT LIABILITY, CONTRIBUTION, BREACH OF WARRANTY, OR
OTHER LEGAL EQUITABLE THEORY ANY DIRECT OR INDIRECT DAMAGES OR EXPENSES
INCLUDING BUT NOT LIMITED TO ANY INCIDENTAL, SPECIAL, INDIRECT, PUNITIVE OR
CONSEQUENTIAL DAMAGES, LOST PROFITS OR LOST DATA, COST OF PROCUREMENT OF
SUBSTITUTE GOODS, TECHNOLOGY, SERVICES, OR ANY CLAIMS BY THIRD PARTIES
(INCLUDING BUT NOT LIMITED TO ANY DEFENSE THEREOF), OR OTHER SIMILAR COSTS.
*******************************************************************************/
// DOM-IGNORE-END

#ifndef _SYSTEM_CONFIG_H
#define _SYSTEM_CONFIG_H

// *****************************************************************************
// *****************************************************************************
// Section: Included Files
// *****************************************************************************
// *****************************************************************************
/*  This section Includes other configuration headers necessary to completely
    define this configuration.
*/


// DOM-IGNORE-BEGIN
#ifdef __cplusplus  // Provide C++ Compatibility

extern "C" {

#endif
// DOM-IGNORE-END

// *****************************************************************************
// *****************************************************************************
// Section: System Service Configuration
// *****************************************************************************
// *****************************************************************************
// *****************************************************************************
/* Common System Service Configuration Options
*/
#define SYS_VERSION_STR           "2.06"
#define SYS_VERSION               20600

// *****************************************************************************
/* Clock System Service Configuration Options
*/
#define SYS_CLK_FREQ                        40000000ul
#define SYS_CLK_BUS_PERIPHERAL_1            40000000ul
#define SYS_CLK_UPLL_BEFORE_DIV2_FREQ       192000000ul
#define SYS_CLK_CONFIG_PRIMARY_XTAL         8000000ul
#define SYS_CLK_CONFIG_SECONDARY_XTAL       32768ul
   
/*** Ports System Service Configuration ***/
#define SYS_PORT_A_ANSEL        0xF87C
#define SYS_PORT_A_TRIS         0xFDFC
#define SYS_PORT_A_LAT          0x0000
#define SYS_PORT_A_ODC          0x0000
#define SYS_PORT_A_CNPU         0x0000
#define SYS_PORT_A_CNPD         0x0000
#define SYS_PORT_A_CNEN         0x0000

#define SYS_PORT_B_ANSEL        0x0018
#define SYS_PORT_B_TRIS         0xE0D8
#define SYS_PORT_B_LAT          0x0000
#define SYS_PORT_B_ODC          0x0000
#define SYS_PORT_B_CNPU         0x0000
#define SYS_PORT_B_CNPD         0x0000
#define SYS_PORT_B_CNEN         0x0000

#define SYS_PORT_C_ANSEL        0xFC08
#define SYS_PORT_C_TRIS         0xFD7F
#define SYS_PORT_C_LAT          0x0000
#define SYS_PORT_C_ODC          0x0000
#define SYS_PORT_C_CNPU         0x0000
#define SYS_PORT_C_CNPD         0x0000
#define SYS_PORT_C_CNEN         0x0000


/*** Interrupt System Service Configuration ***/
#define SYS_INT                     true

// *****************************************************************************
// *****************************************************************************
// Section: Driver Configuration
// *****************************************************************************
// *****************************************************************************
/*** Timer Driver Configuration ***/
#define DRV_TMR_INTERRUPT_MODE             true

/*** Timer Driver 0 Configuration ***/
#define DRV_TMR_PERIPHERAL_ID_IDX0          TMR_ID_1
#define DRV_TMR_INTERRUPT_SOURCE_IDX0       INT_SOURCE_TIMER_1
#define DRV_TMR_INTERRUPT_VECTOR_IDX0       INT_VECTOR_T1
#define DRV_TMR_ISR_VECTOR_IDX0             _TIMER_1_VECTOR
#define DRV_TMR_INTERRUPT_PRIORITY_IDX0     INT_PRIORITY_LEVEL1
#define DRV_TMR_INTERRUPT_SUB_PRIORITY_IDX0 INT_SUBPRIORITY_LEVEL0
#define DRV_TMR_CLOCK_SOURCE_IDX0           DRV_TMR_CLKSOURCE_INTERNAL
#define DRV_TMR_PRESCALE_IDX0               TMR_PRESCALE_VALUE_8
#define DRV_TMR_OPERATION_MODE_IDX0         DRV_TMR_OPERATION_MODE_16_BIT
#define DRV_TMR_ASYNC_WRITE_ENABLE_IDX0     false
#define DRV_TMR_POWER_STATE_IDX0            

#define DRV_TMR_PERIPHERAL_ID_IDX1          TMR_ID_2
#define DRV_TMR_INTERRUPT_SOURCE_IDX1       INT_SOURCE_TIMER_2
#define DRV_TMR_INTERRUPT_VECTOR_IDX1       INT_VECTOR_T2
#define DRV_TMR_ISR_VECTOR_IDX1             _TIMER_2_VECTOR
#define DRV_TMR_INTERRUPT_PRIORITY_IDX1     INT_PRIORITY_LEVEL3
#define DRV_TMR_INTERRUPT_SUB_PRIORITY_IDX1 INT_SUBPRIORITY_LEVEL0
#define DRV_TMR_CLOCK_SOURCE_IDX1           DRV_TMR_CLKSOURCE_INTERNAL
#define DRV_TMR_PRESCALE_IDX1               TMR_PRESCALE_VALUE_4
#define DRV_TMR_OPERATION_MODE_IDX1         DRV_TMR_OPERATION_MODE_16_BIT

#define DRV_TMR_ASYNC_WRITE_ENABLE_IDX1     false
#define DRV_TMR_POWER_STATE_IDX1            
/*** Timer Driver 2 Configuration ***/
#define DRV_TMR_PERIPHERAL_ID_IDX2          TMR_ID_4
#define DRV_TMR_INTERRUPT_SOURCE_IDX2       INT_SOURCE_TIMER_5
#define DRV_TMR_INTERRUPT_VECTOR_IDX2       INT_VECTOR_T5
#define DRV_TMR_ISR_VECTOR_IDX2             _TIMER_5_VECTOR
#define DRV_TMR_INTERRUPT_PRIORITY_IDX2     INT_PRIORITY_LEVEL1
#define DRV_TMR_INTERRUPT_SUB_PRIORITY_IDX2 INT_SUBPRIORITY_LEVEL0
#define DRV_TMR_CLOCK_SOURCE_IDX2           DRV_TMR_CLKSOURCE_INTERNAL
#define DRV_TMR_PRESCALE_IDX2               TMR_PRESCALE_VALUE_256
#define DRV_TMR_OPERATION_MODE_IDX2         DRV_TMR_OPERATION_MODE_32_BIT
#define DRV_TMR_ASYNC_WRITE_ENABLE_IDX2     false
#define DRV_TMR_POWER_STATE_IDX2            

 // *****************************************************************************
/* USART Driver Configuration Options
*/
#define DRV_USART_INSTANCES_NUMBER                  1
#define DRV_USART_CLIENTS_NUMBER                    1
#define DRV_USART_INTERRUPT_MODE                    false
#define DRV_USART_BYTE_MODEL_SUPPORT                true
#define DRV_USART_READ_WRITE_MODEL_SUPPORT          false
#define DRV_USART_BUFFER_QUEUE_SUPPORT              false

// *****************************************************************************
// *****************************************************************************
// Section: Middleware & Other Library Configuration
// *****************************************************************************
// *****************************************************************************



// *****************************************************************************
// *****************************************************************************
// Section: Application Configuration
// *****************************************************************************
// *****************************************************************************
/*** Application Defined Pins ***/

/*** Functions for LED_R pin ***/
#define LED_RToggle() PLIB_PORTS_PinToggle(PORTS_ID_0, PORT_CHANNEL_B, PORTS_BIT_POS_9)
#define LED_ROn() PLIB_PORTS_PinSet(PORTS_ID_0, PORT_CHANNEL_B, PORTS_BIT_POS_9)
#define LED_ROff() PLIB_PORTS_PinClear(PORTS_ID_0, PORT_CHANNEL_B, PORTS_BIT_POS_9)
#define LED_RStateGet() PLIB_PORTS_PinGetLatched(PORTS_ID_0, PORT_CHANNEL_B, PORTS_BIT_POS_9)
#define LED_RStateSet(Value) PLIB_PORTS_PinWrite(PORTS_ID_0, PORT_CHANNEL_B, PORTS_BIT_POS_9, Value)

/*** Functions for BUZZER pin ***/
#define BUZZERToggle() PLIB_PORTS_PinToggle(PORTS_ID_0, PORT_CHANNEL_C, PORTS_BIT_POS_7)
#define BUZZEROn() PLIB_PORTS_PinSet(PORTS_ID_0, PORT_CHANNEL_C, PORTS_BIT_POS_7)
#define BUZZEROff() PLIB_PORTS_PinClear(PORTS_ID_0, PORT_CHANNEL_C, PORTS_BIT_POS_7)
#define BUZZERStateGet() PLIB_PORTS_PinGetLatched(PORTS_ID_0, PORT_CHANNEL_C, PORTS_BIT_POS_7)
#define BUZZERStateSet(Value) PLIB_PORTS_PinWrite(PORTS_ID_0, PORT_CHANNEL_C, PORTS_BIT_POS_7, Value)

/*** Functions for LED_G pin ***/
#define LED_GToggle() PLIB_PORTS_PinToggle(PORTS_ID_0, PORT_CHANNEL_B, PORTS_BIT_POS_10)
#define LED_GOn() PLIB_PORTS_PinSet(PORTS_ID_0, PORT_CHANNEL_B, PORTS_BIT_POS_10)
#define LED_GOff() PLIB_PORTS_PinClear(PORTS_ID_0, PORT_CHANNEL_B, PORTS_BIT_POS_10)
#define LED_GStateGet() PLIB_PORTS_PinGetLatched(PORTS_ID_0, PORT_CHANNEL_B, PORTS_BIT_POS_10)
#define LED_GStateSet(Value) PLIB_PORTS_PinWrite(PORTS_ID_0, PORT_CHANNEL_B, PORTS_BIT_POS_10, Value)

/*** Functions for LED_B pin ***/
#define LED_BToggle() PLIB_PORTS_PinToggle(PORTS_ID_0, PORT_CHANNEL_B, PORTS_BIT_POS_11)
#define LED_BOn() PLIB_PORTS_PinSet(PORTS_ID_0, PORT_CHANNEL_B, PORTS_BIT_POS_11)
#define LED_BOff() PLIB_PORTS_PinClear(PORTS_ID_0, PORT_CHANNEL_B, PORTS_BIT_POS_11)
#define LED_BStateGet() PLIB_PORTS_PinGetLatched(PORTS_ID_0, PORT_CHANNEL_B, PORTS_BIT_POS_11)
#define LED_BStateSet(Value) PLIB_PORTS_PinWrite(PORTS_ID_0, PORT_CHANNEL_B, PORTS_BIT_POS_11, Value)

/*** Functions for LED_VIE pin ***/
#define LED_VIEToggle() PLIB_PORTS_PinToggle(PORTS_ID_0, PORT_CHANNEL_B, PORTS_BIT_POS_12)
#define LED_VIEOn() PLIB_PORTS_PinSet(PORTS_ID_0, PORT_CHANNEL_B, PORTS_BIT_POS_12)
#define LED_VIEOff() PLIB_PORTS_PinClear(PORTS_ID_0, PORT_CHANNEL_B, PORTS_BIT_POS_12)
#define LED_VIEStateGet() PLIB_PORTS_PinGetLatched(PORTS_ID_0, PORT_CHANNEL_B, PORTS_BIT_POS_12)
#define LED_VIEStateSet(Value) PLIB_PORTS_PinWrite(PORTS_ID_0, PORT_CHANNEL_B, PORTS_BIT_POS_12, Value)

/*** Functions for LCD_RS pin ***/
#define LCD_RSToggle() PLIB_PORTS_PinToggle(PORTS_ID_0, PORT_CHANNEL_B, PORTS_BIT_POS_0)
#define LCD_RSOn() PLIB_PORTS_PinSet(PORTS_ID_0, PORT_CHANNEL_B, PORTS_BIT_POS_0)
#define LCD_RSOff() PLIB_PORTS_PinClear(PORTS_ID_0, PORT_CHANNEL_B, PORTS_BIT_POS_0)
#define LCD_RSStateGet() PLIB_PORTS_PinGetLatched(PORTS_ID_0, PORT_CHANNEL_B, PORTS_BIT_POS_0)
#define LCD_RSStateSet(Value) PLIB_PORTS_PinWrite(PORTS_ID_0, PORT_CHANNEL_B, PORTS_BIT_POS_0, Value)

/*** Functions for LCD_RW pin ***/
#define LCD_RWToggle() PLIB_PORTS_PinToggle(PORTS_ID_0, PORT_CHANNEL_B, PORTS_BIT_POS_1)
#define LCD_RWOn() PLIB_PORTS_PinSet(PORTS_ID_0, PORT_CHANNEL_B, PORTS_BIT_POS_1)
#define LCD_RWOff() PLIB_PORTS_PinClear(PORTS_ID_0, PORT_CHANNEL_B, PORTS_BIT_POS_1)
#define LCD_RWStateGet() PLIB_PORTS_PinGetLatched(PORTS_ID_0, PORT_CHANNEL_B, PORTS_BIT_POS_1)
#define LCD_RWStateSet(Value) PLIB_PORTS_PinWrite(PORTS_ID_0, PORT_CHANNEL_B, PORTS_BIT_POS_1, Value)

/*** Functions for LCD_E pin ***/
#define LCD_EToggle() PLIB_PORTS_PinToggle(PORTS_ID_0, PORT_CHANNEL_B, PORTS_BIT_POS_2)
#define LCD_EOn() PLIB_PORTS_PinSet(PORTS_ID_0, PORT_CHANNEL_B, PORTS_BIT_POS_2)
#define LCD_EOff() PLIB_PORTS_PinClear(PORTS_ID_0, PORT_CHANNEL_B, PORTS_BIT_POS_2)
#define LCD_EStateGet() PLIB_PORTS_PinGetLatched(PORTS_ID_0, PORT_CHANNEL_B, PORTS_BIT_POS_2)
#define LCD_EStateSet(Value) PLIB_PORTS_PinWrite(PORTS_ID_0, PORT_CHANNEL_B, PORTS_BIT_POS_2, Value)

/*** Functions for LED_DEBUG pin ***/
#define LED_DEBUGToggle() PLIB_PORTS_PinToggle(PORTS_ID_0, PORT_CHANNEL_A, PORTS_BIT_POS_9)
#define LED_DEBUGOn() PLIB_PORTS_PinSet(PORTS_ID_0, PORT_CHANNEL_A, PORTS_BIT_POS_9)
#define LED_DEBUGOff() PLIB_PORTS_PinClear(PORTS_ID_0, PORT_CHANNEL_A, PORTS_BIT_POS_9)
#define LED_DEBUGStateGet() PLIB_PORTS_PinGetLatched(PORTS_ID_0, PORT_CHANNEL_A, PORTS_BIT_POS_9)
#define LED_DEBUGStateSet(Value) PLIB_PORTS_PinWrite(PORTS_ID_0, PORT_CHANNEL_A, PORTS_BIT_POS_9, Value)

/*** Functions for LCD_BL pin ***/
#define LCD_BLToggle() PLIB_PORTS_PinToggle(PORTS_ID_0, PORT_CHANNEL_B, PORTS_BIT_POS_8)
#define LCD_BLOn() PLIB_PORTS_PinSet(PORTS_ID_0, PORT_CHANNEL_B, PORTS_BIT_POS_8)
#define LCD_BLOff() PLIB_PORTS_PinClear(PORTS_ID_0, PORT_CHANNEL_B, PORTS_BIT_POS_8)
#define LCD_BLStateGet() PLIB_PORTS_PinGetLatched(PORTS_ID_0, PORT_CHANNEL_B, PORTS_BIT_POS_8)
#define LCD_BLStateSet(Value) PLIB_PORTS_PinWrite(PORTS_ID_0, PORT_CHANNEL_B, PORTS_BIT_POS_8, Value)

/*** Functions for PIN_WIRE pin ***/
#define PIN_WIREStateGet() PLIB_PORTS_PinGet(PORTS_ID_0, PORT_CHANNEL_C, PORTS_BIT_POS_6)

/*** Functions for   PEC12_A pin ***/
#define   PEC12_AStateGet() PLIB_PORTS_PinGet(PORTS_ID_0, PORT_CHANNEL_B, PORTS_BIT_POS_13)

/*** Functions for   PEC12_B pin ***/
#define   PEC12_BStateGet() PLIB_PORTS_PinGet(PORTS_ID_0, PORT_CHANNEL_B, PORTS_BIT_POS_14)

/*** Functions for   PEC12_PB pin ***/
#define   PEC12_PBStateGet() PLIB_PORTS_PinGet(PORTS_ID_0, PORT_CHANNEL_B, PORTS_BIT_POS_15)

/*** Functions for PIN_START pin ***/
#define PIN_STARTStateGet() PLIB_PORTS_PinGet(PORTS_ID_0, PORT_CHANNEL_C, PORTS_BIT_POS_4)

/*** Functions for PIN_STOP pin ***/
#define PIN_STOPStateGet() PLIB_PORTS_PinGet(PORTS_ID_0, PORT_CHANNEL_C, PORTS_BIT_POS_5)


/*** Application Instance 0 Configuration ***/

//DOM-IGNORE-BEGIN
#ifdef __cplusplus
}
#endif
//DOM-IGNORE-END

#endif // _SYSTEM_CONFIG_H
/*******************************************************************************
 End of File
*/
